bigstrongbeast/GBK-Gubkinskiy/Laser/5/mm=5_x1_10.07.26_GBK bottom 0125_FPlen=2980_FPwid=1480.dxf

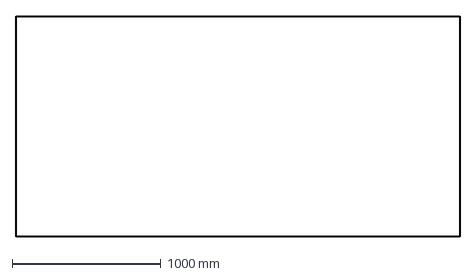
[picture p3: CAD file, 2026-08-14]
Laser/5/mm=5_x1_10.07.26_GBK bottom 0125_FPlen=2980_FPwid=1480.dxf
2980.0 x 1480.0 mm
