bigstrongbeast/GBK-Gubkinskiy/распред камера губкинск лазер/22.09.26_GBK-RK-0034 tube segmeng 4.dxf

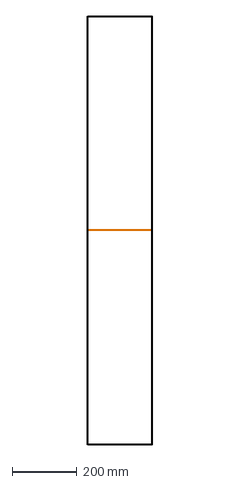
[picture p5: CAD file, 2026-09-22]
распред камера губкинск лазер/22.09.26_GBK-RK-0034 tube segmeng 4.dxf
200.0 x 1327.4 mm
