bigstrongbeast/GBK-Gubkinskiy/Laser/5/mm=5_x1_10.07.26_GBK bottom 0125_FPwid=1480_Project=.dxf

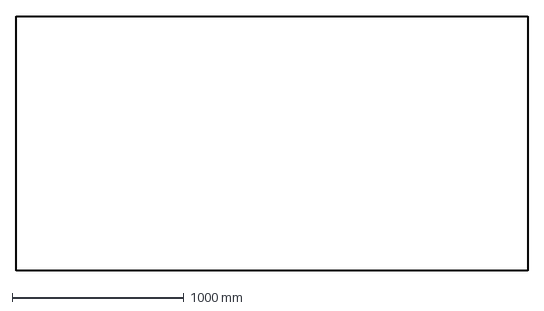
[picture p6: CAD file, 2026-08-14]
Laser/5/mm=5_x1_10.07.26_GBK bottom 0125_FPwid=1480_Project=.dxf
2980.0 x 1480.0 mm
