bigstrongbeast/GBK-Gubkinskiy/Laser/mm=2_x2_23.10.26_GBK-RK-0051 Cipolletti R.dxf

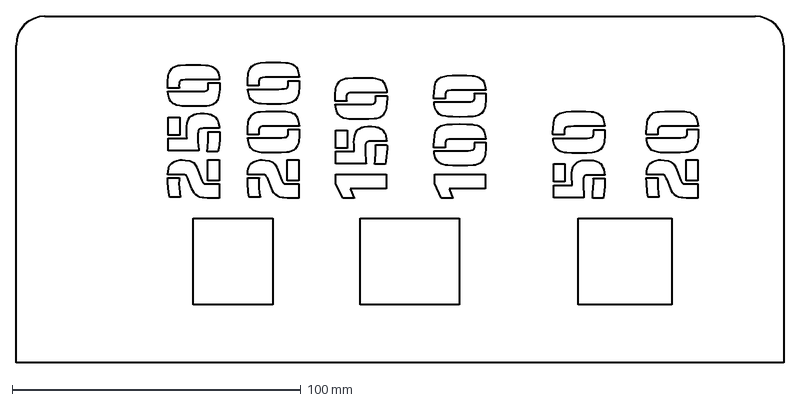
[picture p7: CAD file, 2026-10-23]
Laser/mm=2_x2_23.10.26_GBK-RK-0051 Cipolletti R.dxf
266.0 x 120.0 mm
