bigstrongbeast/GBK-Gubkinskiy/распред камера губкинск лазер/22.09.26_Деталь2.dxf

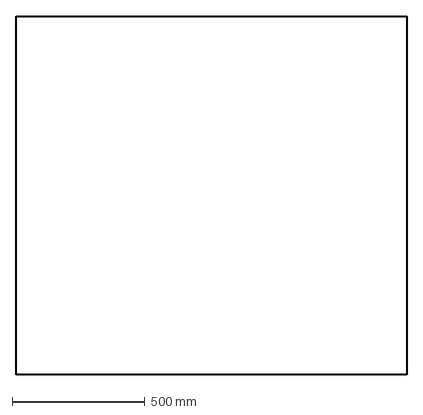
[picture p8: CAD file, 2026-09-22]
распред камера губкинск лазер/22.09.26_Деталь2.dxf
1471.0 x 1350.0 mm
