bigstrongbeast/GBK-Gubkinskiy/Распредкамера/23.10.26_2mm_x2_GBK-RK-0052 weir scale L.dxf

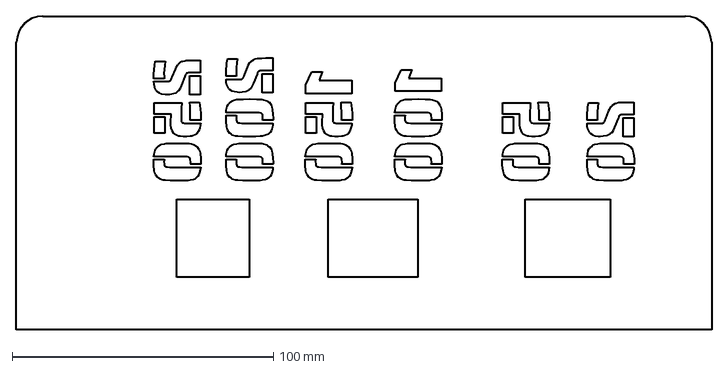
[picture p9: CAD file, 2026-10-23]
Распредкамера/23.10.26_2mm_x2_GBK-RK-0052 weir scale L.dxf
266.0 x 120.0 mm
