bigstrongbeast/GBK-Gubkinskiy/GBK 0001 Чертежи лазер 10.09.26.dxf

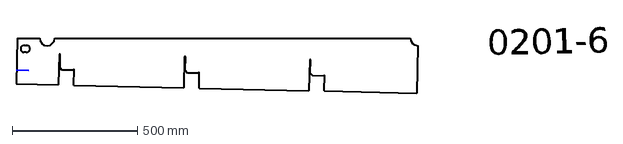
[picture p10: CAD file, 2026-09-14]
GBK 0001 Чертежи лазер 10.09.26.dxf
0201-6
