bigstrongbeast/GBK-Gubkinskiy/распред камера губкинск лазер/22.09.26_GBK-RK-0032 tube segmeng 2.dxf

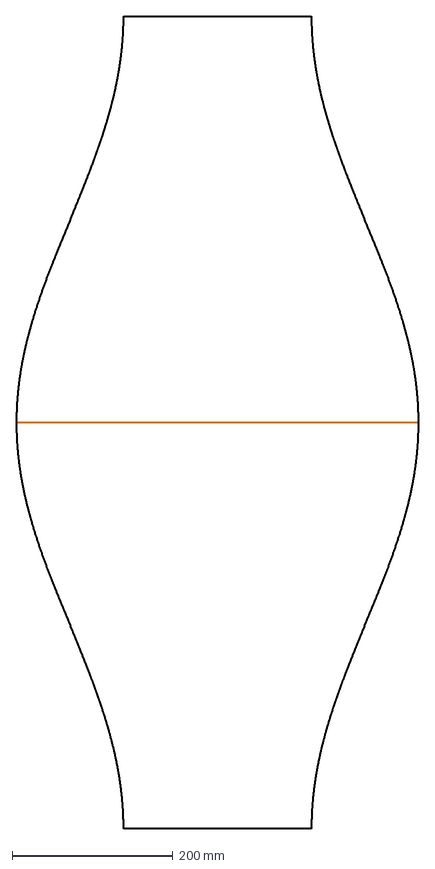
[picture p13: CAD file, 2026-09-22]
распред камера губкинск лазер/22.09.26_GBK-RK-0032 tube segmeng 2.dxf
500.0 x 1010.2 mm
