bigstrongbeast/GBK-Gubkinskiy/Распредкамера/23.10.26_2mm_x2_GBK-RK-0051 weir scale R.dxf

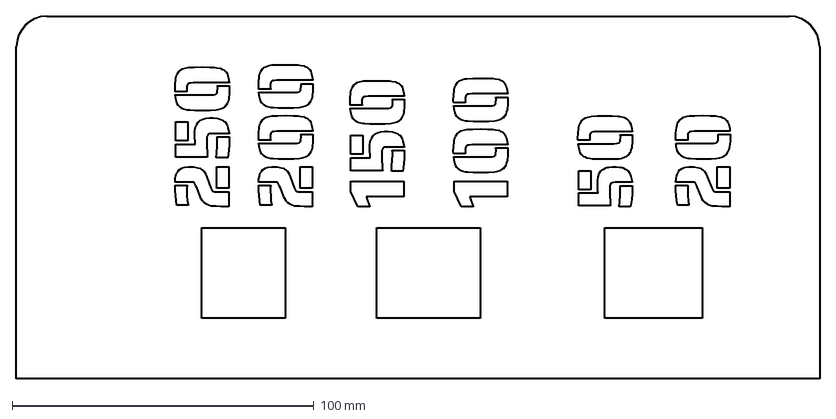
[picture p14: CAD file, 2026-10-23]
Распредкамера/23.10.26_2mm_x2_GBK-RK-0051 weir scale R.dxf
266.0 x 120.0 mm
