bigstrongbeast/GBK-Gubkinskiy/Laser/5/mm=5_x1_10.07.26_GBK bottom 0134_FPlen=1484_FPwid=64.dxf

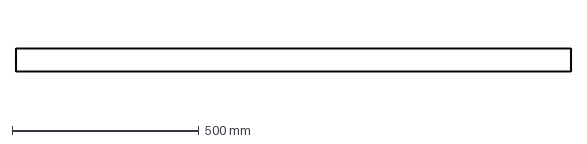
[picture p15: CAD file, 2026-08-14]
Laser/5/mm=5_x1_10.07.26_GBK bottom 0134_FPlen=1484_FPwid=64.dxf
1484.0 x 64.0 mm
