bigstrongbeast/GBK-Gubkinskiy/распред камера губкинск лазер/22.09.26_GBK-RK-0018 long wall 4.dxf

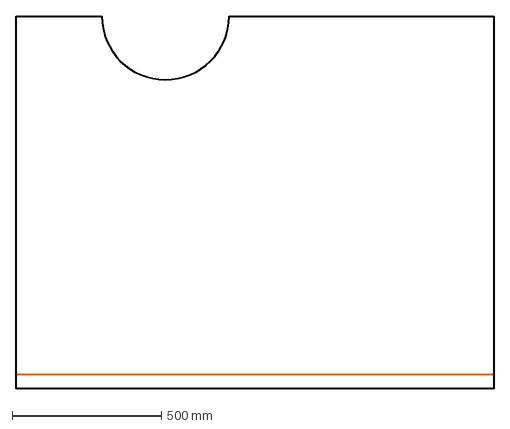
[picture p17: CAD file, 2026-09-22]
распред камера губкинск лазер/22.09.26_GBK-RK-0018 long wall 4.dxf
1600.0 x 1248.4 mm
