bigstrongbeast/GBK-Gubkinskiy/Распредкамера/GBK-RK-0831 ring plate.dxf

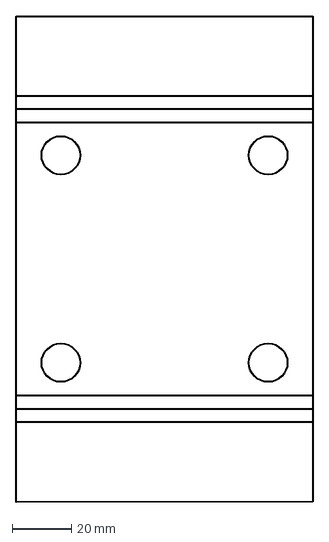
[picture p18: CAD file, 2026-10-08]
Распредкамера/GBK-RK-0831 ring plate.dxf
100.0 x 164.1 mm
