bigstrongbeast/GBK-Gubkinskiy/GBK 0001 на лазер 07.09.2026.dxf

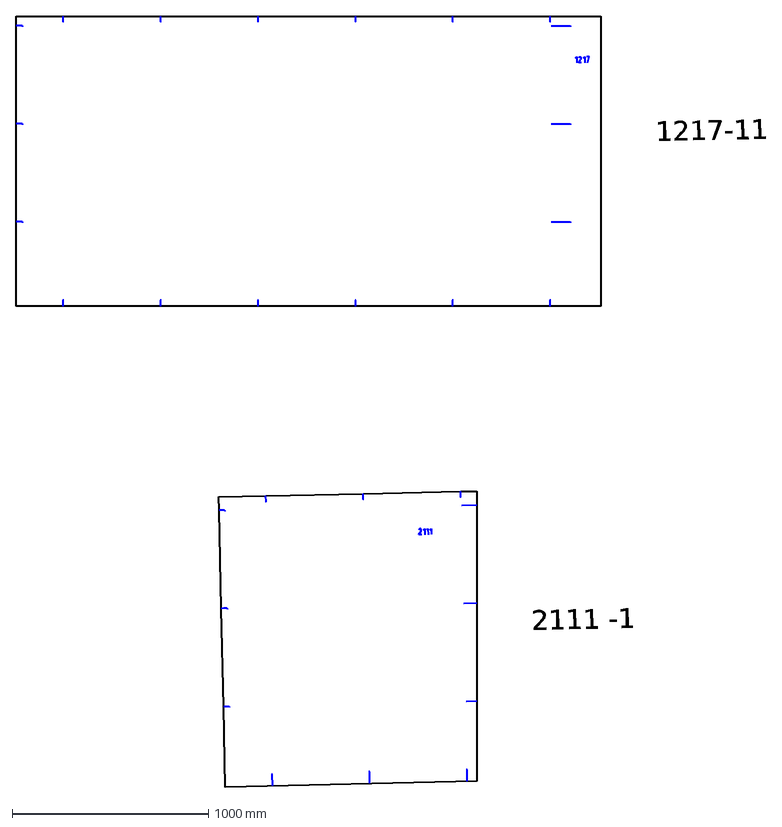
[picture p19: CAD file, 2026-09-14]
GBK 0001 на лазер 07.09.2026.dxf
1217-11
2111 -1
