bigstrongbeast/GBK-Gubkinskiy/Laser/5/mm=5_x1_10.07.26_GBK bottom 0135_FPwid=64_Project=.dxf

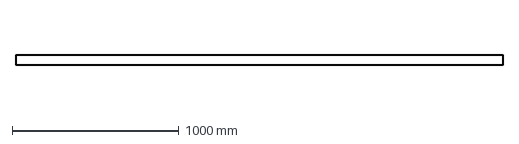
[picture p20: CAD file, 2026-08-14]
Laser/5/mm=5_x1_10.07.26_GBK bottom 0135_FPwid=64_Project=.dxf
2920.0 x 64.0 mm
