bigstrongbeast/GBK-Gubkinskiy/Распредкамера/05.10.26_3mm_8pc_GBK-RK-0832 ring plate.dxf

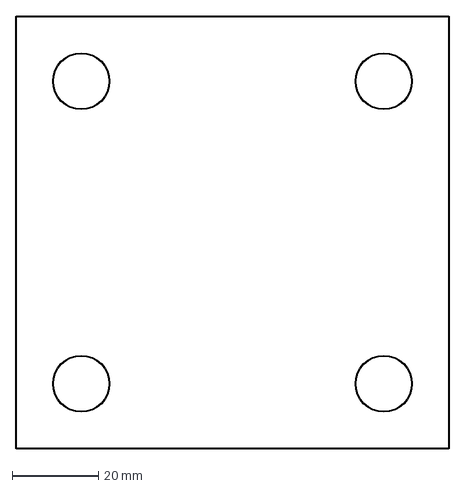
[picture p23: CAD file, 2026-10-08]
Распредкамера/05.10.26_3mm_8pc_GBK-RK-0832 ring plate.dxf
100.0 x 100.0 mm
