bigstrongbeast/GBK-Gubkinskiy/Laser/mm=2_x12_22.09.26_GBK-RK-0043 rib 3.dxf

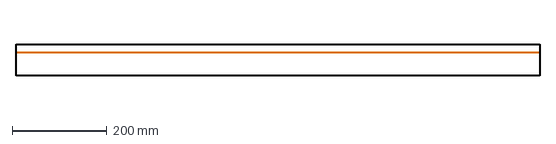
[picture p25: CAD file, 2026-09-23]
Laser/mm=2_x12_22.09.26_GBK-RK-0043 rib 3.dxf
1104.0 x 66.5 mm
