bigstrongbeast/GBK-Gubkinskiy/распред камера губкинск лазер/22.09.26_GBK-RK-0014 short wall 4.dxf

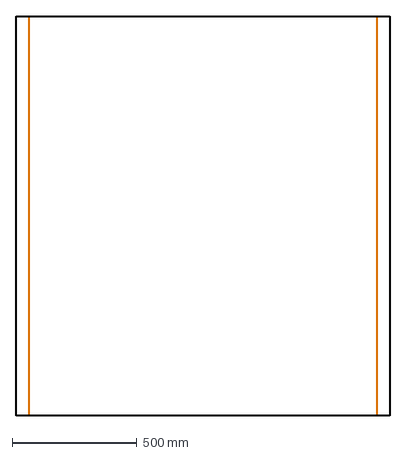
[picture p26: CAD file, 2026-09-22]
распред камера губкинск лазер/22.09.26_GBK-RK-0014 short wall 4.dxf
1496.8 x 1600.0 mm
