bigstrongbeast/GBK-Gubkinskiy/Распредкамера/GBK-RK-0832 ring plate.dxf

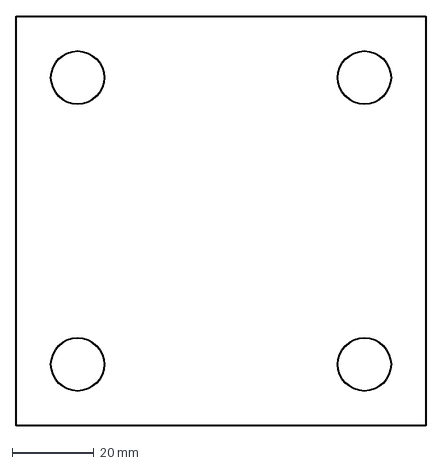
[picture p27: CAD file, 2026-10-08]
Распредкамера/GBK-RK-0832 ring plate.dxf
100.0 x 100.0 mm
