bigstrongbeast/GBK-Gubkinskiy/Laser/5/mm=5_x3_10.07.26_GBK bottom 0233.dxf

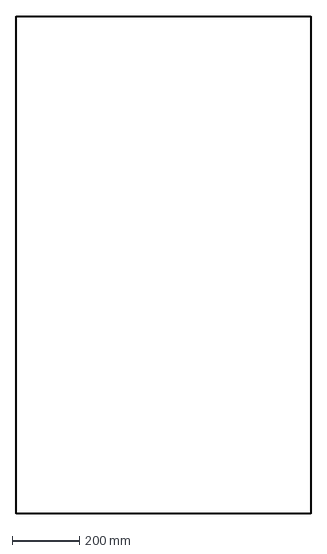
[picture p28: CAD file, 2026-07-15]
Laser/5/mm=5_x3_10.07.26_GBK bottom 0233.dxf
876.0 x 1480.0 mm
