bigstrongbeast/GBK-Gubkinskiy/Laser/mm=4_x1_22.09.26_GBK-RK-0021 bottom.dxf

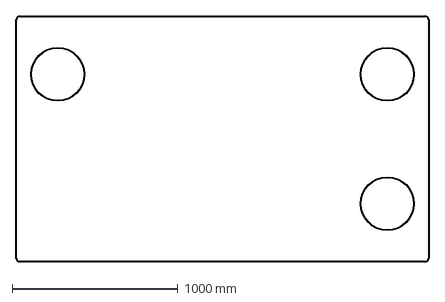
[picture p29: CAD file, 2026-09-23]
Laser/mm=4_x1_22.09.26_GBK-RK-0021 bottom.dxf
2488.0 x 1480.0 mm
