bigstrongbeast/GBK-Gubkinskiy/распред камера губкинск лазер/22.09.26_GBK-RK-0015 partition 5.dxf

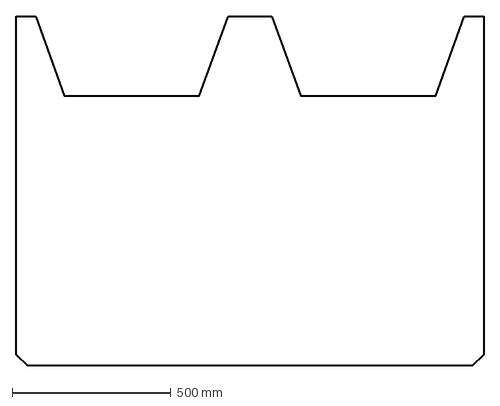
[picture p30: CAD file, 2026-09-22]
распред камера губкинск лазер/22.09.26_GBK-RK-0015 partition 5.dxf
1470.0 x 1100.0 mm
