bigstrongbeast/GBK-Gubkinskiy/Распредкамера/05.10.26_3mm_8pc_GBK-RK-0831 ring plate.dxf

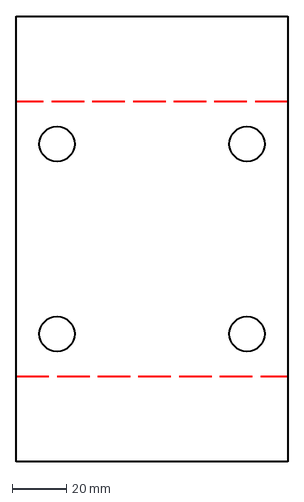
[picture p31: CAD file, 2026-10-08]
Распредкамера/05.10.26_3mm_8pc_GBK-RK-0831 ring plate.dxf
100.0 x 164.1 mm
