bigstrongbeast/GBK-Gubkinskiy/Laser/5/mm=5_x14_10.07.26_0923_CPY.dxf

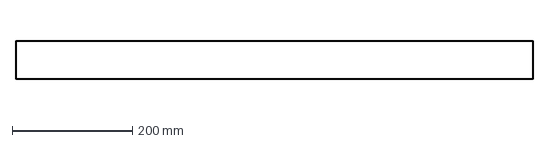
[picture p32: CAD file, 2026-07-15]
Laser/5/mm=5_x14_10.07.26_0923_CPY.dxf
858.0 x 64.0 mm
