bigstrongbeast/GBK-Gubkinskiy/Laser/mm=3_x4_22.09.26_GBK-RK-0018 angle 1.dxf

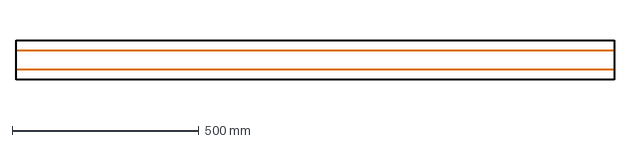
[picture p33: CAD file, 2026-09-23]
Laser/mm=3_x4_22.09.26_GBK-RK-0018 angle 1.dxf
1600.0 x 106.8 mm
