bigstrongbeast/GBK-Gubkinskiy/распред камера губкинск лазер/22.09.26_GBK-RK-0043 rib 3.dxf

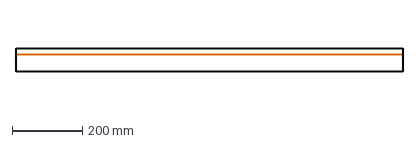
[picture p34: CAD file, 2026-09-22]
распред камера губкинск лазер/22.09.26_GBK-RK-0043 rib 3.dxf
1104.0 x 66.5 mm
