bigstrongbeast/GBK-Gubkinskiy/Laser/5/mm=5_x3_10.07.26_GBK bottom 0231.dxf

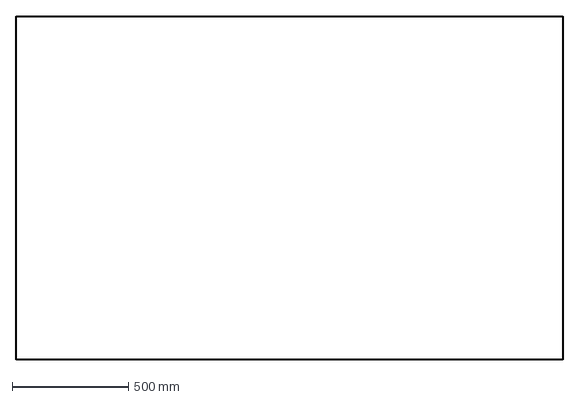
[picture p35: CAD file, 2026-07-15]
Laser/5/mm=5_x3_10.07.26_GBK bottom 0231.dxf
2350.0 x 1480.0 mm
