bigstrongbeast/GBK-Gubkinskiy/Laser/mm=3_x1_22.09.26_GBK-RK-0034 tube segmeng 4.dxf

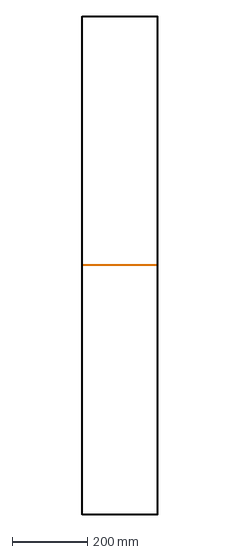
[picture p36: CAD file, 2026-09-23]
Laser/mm=3_x1_22.09.26_GBK-RK-0034 tube segmeng 4.dxf
200.0 x 1327.4 mm
