bigstrongbeast/GBK-Gubkinskiy/распред камера губкинск лазер/22.09.26_GBK-RK-0041 rib 1.dxf

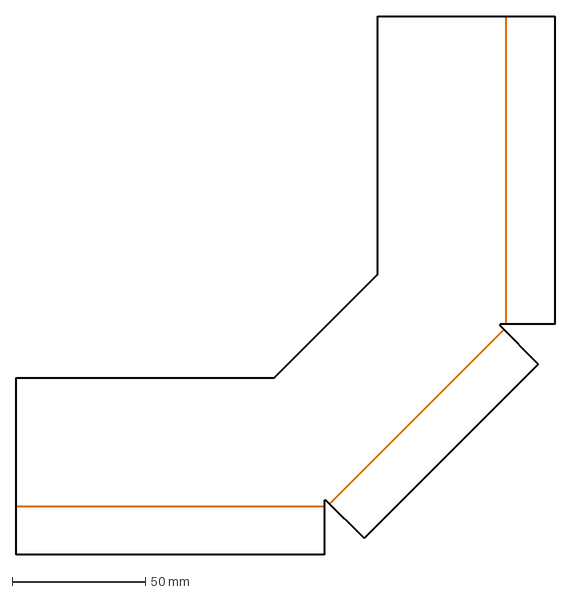
[picture p37: CAD file, 2026-09-22]
распред камера губкинск лазер/22.09.26_GBK-RK-0041 rib 1.dxf
202.4 x 202.4 mm
