bigstrongbeast/GBK-Gubkinskiy/Laser/5/mm=5_x3_10.07.26_0932_CPY1_CPY.dxf

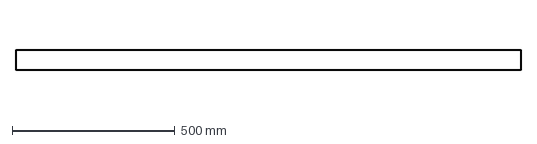
[picture p38: CAD file, 2026-07-15]
Laser/5/mm=5_x3_10.07.26_0932_CPY1_CPY.dxf
1553.0 x 64.0 mm
