bigstrongbeast/GBK-Gubkinskiy/Laser/mm=3_x1_22.09.26_Деталь1.dxf

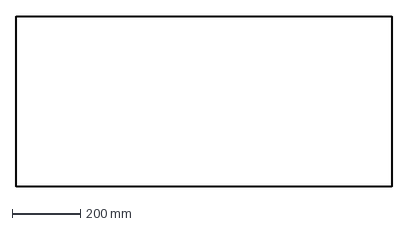
[picture p39: CAD file, 2026-09-23]
Laser/mm=3_x1_22.09.26_Деталь1.dxf
1100.0 x 500.0 mm
