bigstrongbeast/GBK-Gubkinskiy/распред камера губкинск лазер/22.09.26_Деталь1.dxf

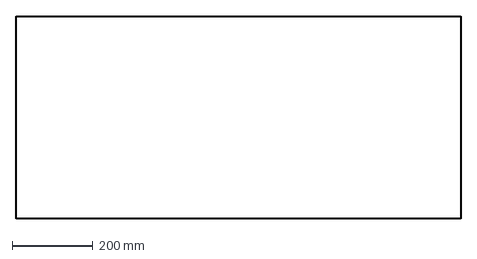
[picture p40: CAD file, 2026-09-22]
распред камера губкинск лазер/22.09.26_Деталь1.dxf
1100.0 x 500.0 mm
