bigstrongbeast/GBK-Gubkinskiy/Laser/5/mm=5_x2_10.07.26_0921_CPY1.dxf

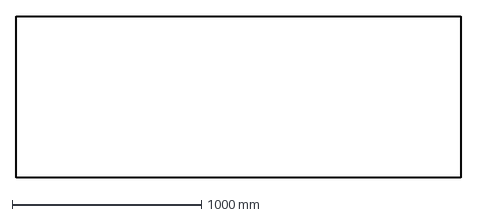
[picture p41: CAD file, 2026-07-15]
Laser/5/mm=5_x2_10.07.26_0921_CPY1.dxf
2350.0 x 854.0 mm
