bigstrongbeast/GBK-Gubkinskiy/распред камера губкинск лазер/22.09.26_GBK-RK-0017 long wall 3.dxf

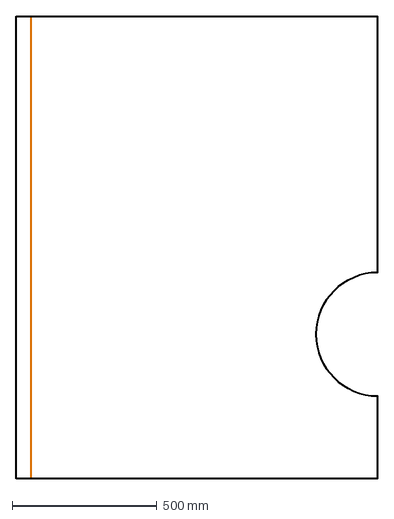
[picture p43: CAD file, 2026-09-22]
распред камера губкинск лазер/22.09.26_GBK-RK-0017 long wall 3.dxf
1248.4 x 1600.0 mm
