bigstrongbeast/GBK-Gubkinskiy/Laser/5/mm=5_x49_10.07.26_0923_CPY1.dxf

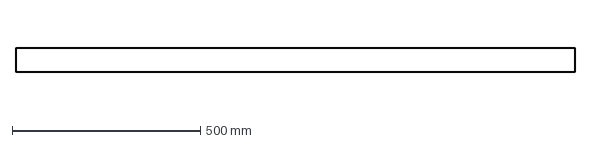
[picture p44: CAD file, 2026-07-15]
Laser/5/mm=5_x49_10.07.26_0923_CPY1.dxf
1484.0 x 64.0 mm
