bigstrongbeast/GBK-Gubkinskiy/Laser/mm=2_x1_22.09.26_GBK-RK-0016 partition 6.dxf

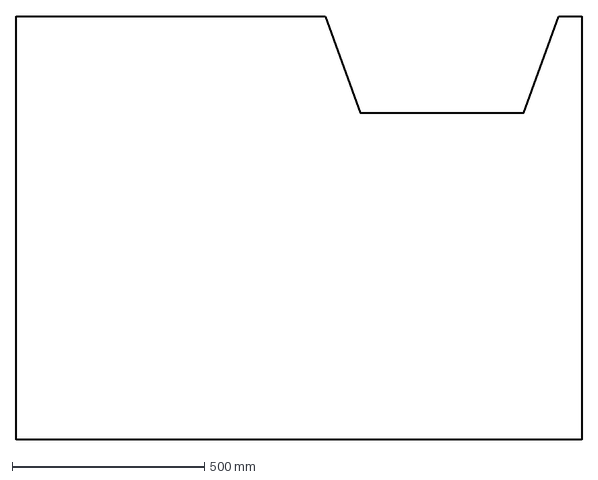
[picture p45: CAD file, 2026-09-23]
Laser/mm=2_x1_22.09.26_GBK-RK-0016 partition 6.dxf
1470.0 x 1100.0 mm
