bigstrongbeast/GBK-Gubkinskiy/распред камера губкинск лазер/22.09.26_GBK-RK-0042 rib 2.dxf

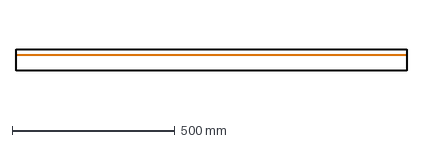
[picture p46: CAD file, 2026-09-22]
распред камера губкинск лазер/22.09.26_GBK-RK-0042 rib 2.dxf
1200.0 x 66.5 mm
