bigstrongbeast/GBK-Gubkinskiy/Laser/5/mm=5_x35_10.07.26_0921_CPY.dxf

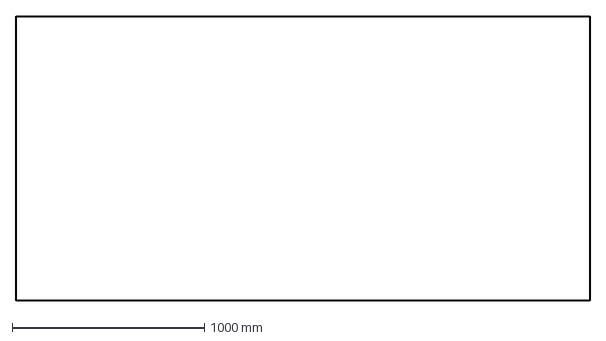
[picture p47: CAD file, 2026-07-15]
Laser/5/mm=5_x35_10.07.26_0921_CPY.dxf
2980.0 x 1480.0 mm
