bigstrongbeast/GBK-Gubkinskiy/распред камера губкинск лазер/22.09.26_GBK-RK-0021 bottom.dxf

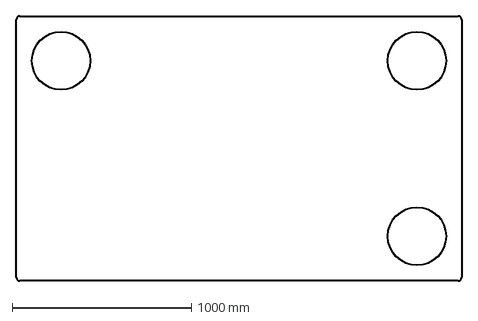
[picture p49: CAD file, 2026-09-22]
распред камера губкинск лазер/22.09.26_GBK-RK-0021 bottom.dxf
2488.0 x 1480.0 mm
