bigstrongbeast/GBK-Gubkinskiy/Laser/5/mm=5_x8_10.07.26_0931_CPY.dxf

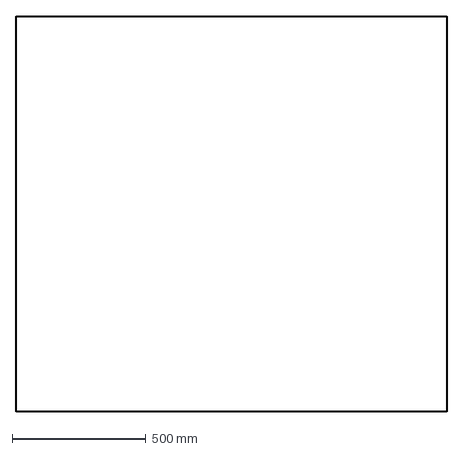
[picture p50: CAD file, 2026-07-15]
Laser/5/mm=5_x8_10.07.26_0931_CPY.dxf
1613.0 x 1480.0 mm
