bigstrongbeast/GBK-Gubkinskiy/Laser/mm=4_x1_22.09.26_GBK-RK-0820 ring plate.dxf

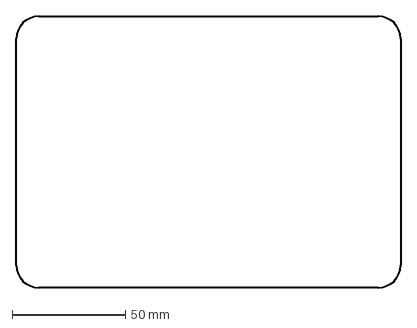
[picture p51: CAD file, 2026-09-23]
Laser/mm=4_x1_22.09.26_GBK-RK-0820 ring plate.dxf
170.0 x 120.0 mm
