bigstrongbeast/GBK-Gubkinskiy/распред камера губкинск лазер/22.09.26_GBK-RK-0031 tube segmeng 1.dxf

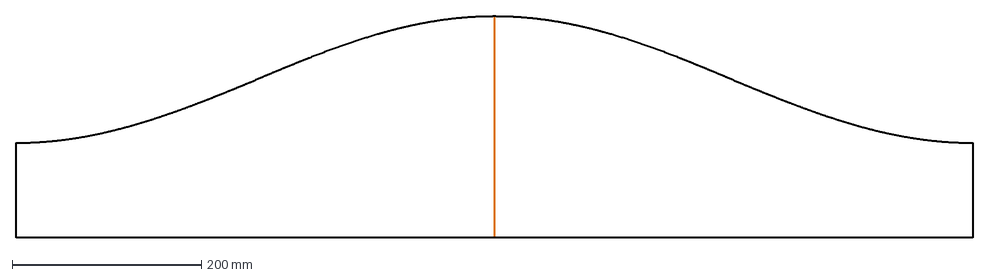
[picture p52: CAD file, 2026-09-22]
распред камера губкинск лазер/22.09.26_GBK-RK-0031 tube segmeng 1.dxf
1010.2 x 233.4 mm
