bigstrongbeast/GBK-Gubkinskiy/Laser/5/mm=5_x10_10.07.26_0921_CPY1_CPY.dxf

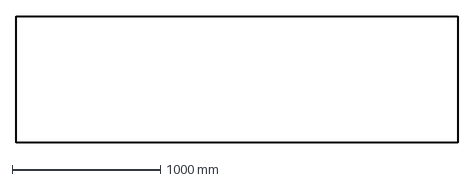
[picture p53: CAD file, 2026-07-15]
Laser/5/mm=5_x10_10.07.26_0921_CPY1_CPY.dxf
2980.0 x 854.0 mm
