bigstrongbeast/GBK-Gubkinskiy/Laser/mm=2_x12_22.09.26_GBK-RK-0041 rib 1.dxf

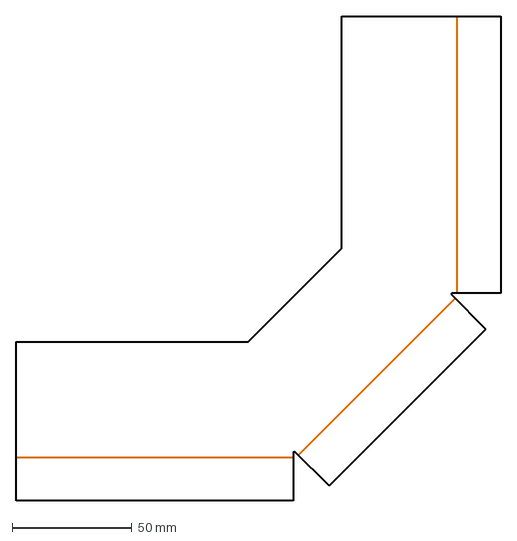
[picture p54: CAD file, 2026-09-23]
Laser/mm=2_x12_22.09.26_GBK-RK-0041 rib 1.dxf
202.4 x 202.4 mm
