bigstrongbeast/GBK-Gubkinskiy/распред камера губкинск лазер/22.09.26_GBK-RK-0013 long wall 3.dxf

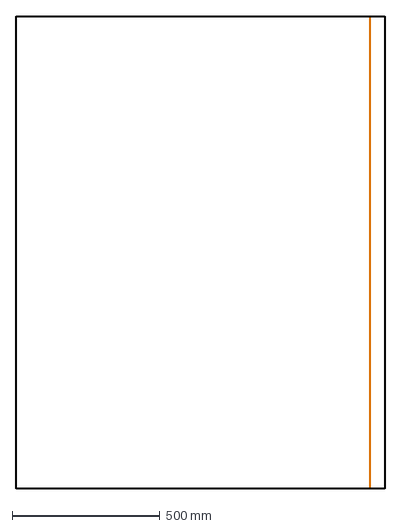
[picture p55: CAD file, 2026-09-22]
распред камера губкинск лазер/22.09.26_GBK-RK-0013 long wall 3.dxf
1248.4 x 1600.0 mm
