bigstrongbeast/GBK-Gubkinskiy/Laser/5/mm=5_x45_10.07.26_0922_CPY1.dxf

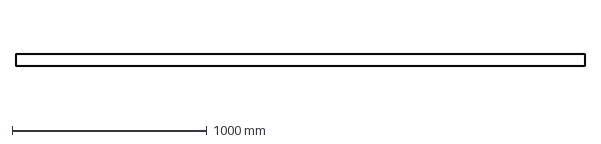
[picture p56: CAD file, 2026-07-15]
Laser/5/mm=5_x45_10.07.26_0922_CPY1.dxf
2920.0 x 64.0 mm
