bigstrongbeast/GBK-Gubkinskiy/Laser/mm=2_x2_22.09.26_Деталь2.dxf

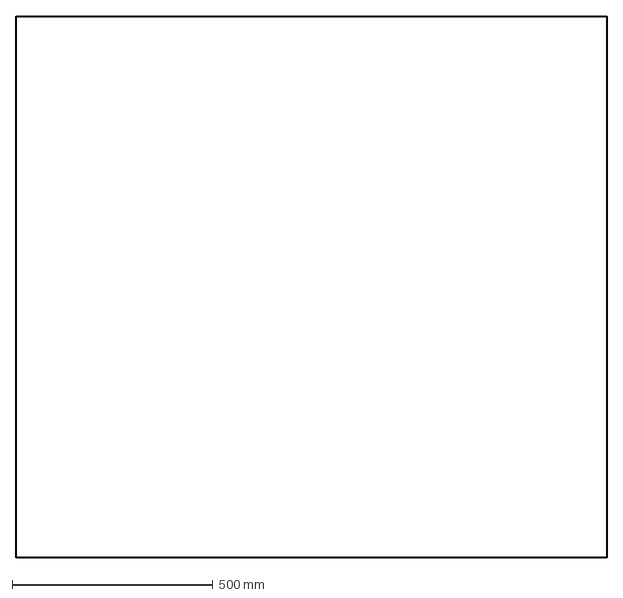
[picture p57: CAD file, 2026-09-23]
Laser/mm=2_x2_22.09.26_Деталь2.dxf
1471.0 x 1350.0 mm
