bigstrongbeast/GBK-Gubkinskiy/распред камера губкинск лазер/22.09.26_GBK-RK-0016 partition 6.dxf

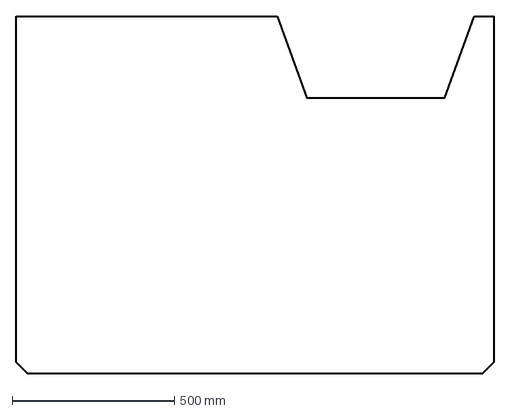
[picture p58: CAD file, 2026-09-22]
распред камера губкинск лазер/22.09.26_GBK-RK-0016 partition 6.dxf
1470.0 x 1100.0 mm
