bigstrongbeast/GBK-Gubkinskiy/Laser/5/mm=5_x2_10.07.26_0931_CPY1.dxf

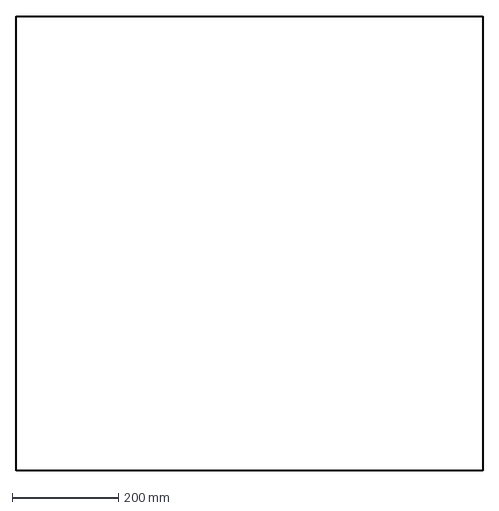
[picture p59: CAD file, 2026-07-15]
Laser/5/mm=5_x2_10.07.26_0931_CPY1.dxf
876.0 x 854.0 mm
