bigstrongbeast/GBK-Gubkinskiy/Laser/mm=4_x2_22.09.26_ухо.dxf

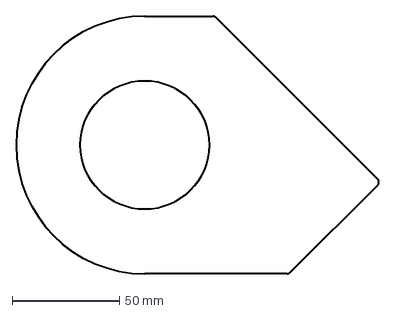
[picture p60: CAD file, 2026-09-23]
Laser/mm=4_x2_22.09.26_ухо.dxf
169.2 x 120.0 mm
