bigstrongbeast/GBK-Gubkinskiy/Laser/mm=3_x1_22.09.26_GBK-RK-0017 long wall 3.dxf

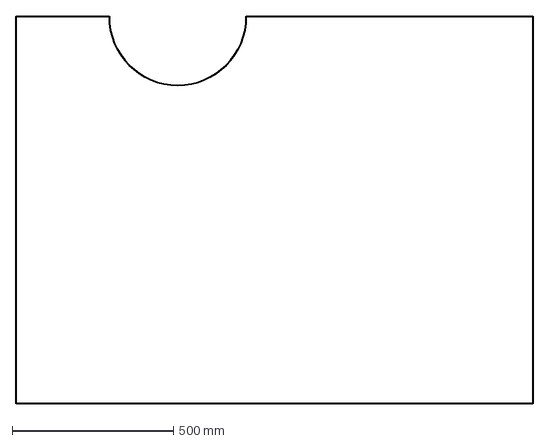
[picture p61: CAD file, 2026-09-23]
Laser/mm=3_x1_22.09.26_GBK-RK-0017 long wall 3.dxf
1600.0 x 1200.0 mm
