bigstrongbeast/GBK-Gubkinskiy/Laser/mm=2_x1_22.09.26_GBK-RK-0015 partition 5.dxf

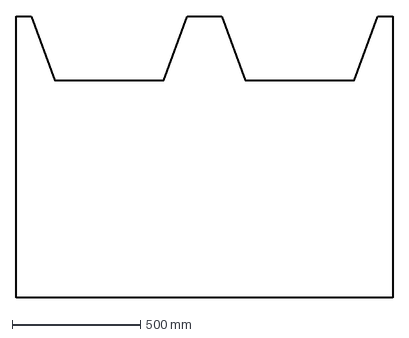
[picture p62: CAD file, 2026-09-23]
Laser/mm=2_x1_22.09.26_GBK-RK-0015 partition 5.dxf
1470.0 x 1100.0 mm
