bigstrongbeast/GBK-Gubkinskiy/Laser/mm=3_x2_22.09.26_GBK-RK-0014 short wall 4.dxf

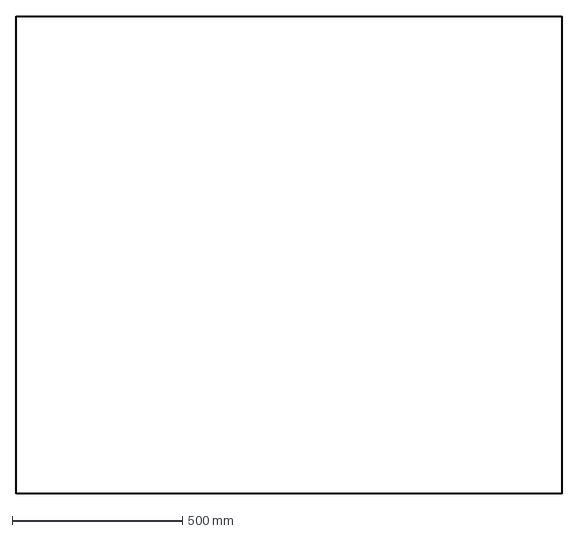
[picture p63: CAD file, 2026-09-23]
Laser/mm=3_x2_22.09.26_GBK-RK-0014 short wall 4.dxf
1600.0 x 1400.0 mm
