bigstrongbeast/GBK-Gubkinskiy/Laser/mm=2_x6_22.09.26_GBK-RK-0042 rib 2.dxf

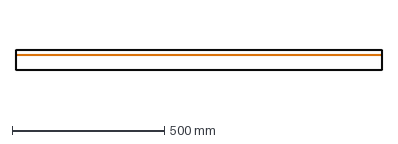
[picture p64: CAD file, 2026-09-23]
Laser/mm=2_x6_22.09.26_GBK-RK-0042 rib 2.dxf
1200.0 x 66.5 mm
