bigstrongbeast/GBK-Gubkinskiy/(list of files, cad)

Other CAD files:
GBK-RK-0001 сборка первое.dwg
Refs/Техсхема Губкинский без резервуара осадка.dwg
Распредкамера/водослив.dwg
GBK-RK-0001.dwg
Refs/емкости в галерее.dwg
Refs/Gubkinskiy_02_27_ rvt (2026 RVT) - Разрез - Section 2.dwg
GBK 0001 на лазер 07.09.26 11_GBK 001 Ребра усилители_3.dwg
GBK 0001 на лазер 07.09.26.dwg
GBK 0001 Чертежи лазер 20.08.26.dxf
GBK 0001 Чертежи гибки.dwg
емкости в галерее 10.07.26.dwg
000 ASY GBK Gubkinskiy CUT LASER.iam
000 ASY GBK Gubkinskiy.iam
01 ASY GBK wall shield 1.1.1.iam
01.3 GBK stringer 1.ipt
010 ASY GBK T beams 1.iam
010 ASY GBK T beams 1/Frame/Frame 1786954762414.iam
010 ASY GBK T beams 1/Frame/ISO 4019 100x100x4 1786954763984.ipt
010 ASY GBK T beams 1/Frame/ISO 4019 100x100x4 1786954764016.ipt
010 ASY GBK T beams 1/Frame/ISO 4019 100x100x4 1786954764050.ipt
010 ASY GBK T beams 1/Frame/ISO 4019 100x100x4 1786954764080.ipt
010 ASY GBK T beams 1/Frame/Skeleton 1786954762415.ipt
010 ASY GBK Tube frame 1.iam
010.7 GBK shield.ipt
01001 ASY GBK wall shield Center 10.iam
01011 GBK Center rib 3.ipt
01013 GBK stringer C7.ipt
01014 GBK stringer C8.ipt
0138 GBK shield 8.ipt
02 ASY GBK wall shield 1.1.2.iam
02.1 GBK main rib.ipt
02.2 GBK rib.ipt
0233 GBK stringer 3.ipt
0241 GBK shield 4.ipt
0241 GBK stringer 4.ipt
0242 GBK stringer 5.ipt
0243 GBK stringer 6.ipt
03.1 GBK main3 rib.ipt
0371 GBK stringer 7.ipt
0372 GBK stringer 8.ipt
0381 GBK stringer 7.ipt
0382 GBK stringer 8.ipt
04.2 GBK rib.ipt
0411 GBK Center main rib.ipt
0413 GBK stringer C1.ipt
0414 GBK stringer C2.ipt
0415 GBK stringer C3.ipt
05.7 GBK shield.ipt
07 ASY GBK wall shield 1.3.1.iam
07.2 GBK rib.ipt
0701 ASY GBK wall shield Center 4.iam
0711 GBK Center rib 2.ipt
0713 GBK stringer C1.ipt
0714 GBK stringer C2.ipt
0715 GBK stringer C3.ipt
08 ASY GBK wall shield 1.3.8.iam
08.2 GBK rib.ipt
090 ASY bottom.iam
1019 GBK shield.ipt
ASY GBK 1110 long wall shield 1.iam
ASY GBK 1120 long wall shield 2.iam
ASY GBK 1210 long wall shield 3.iam
ASY GBK 1310 long wall shield 4.iam
ASY GBK 1320 long wall shield 5.iam
ASY GBK 2110 short wall shield 1.iam
ASY GBK 2120 short wall shield 2.iam
ASY GBK 2130 short wall shield 3.iam
ASY GBK 2210 short wall shield 4.iam
ASY GBK 2220 short wall shield 5.iam
ASY GBK 2230 short wall shield 6.iam
ASY GBK 2310 short wall shield 7.iam
ASY GBK 2320 short wall shield 8.iam
ASY GBK 2330 short wall shield 9.iam
ASY GBK 3110 central wall shield 1.iam
ASY GBK 3120 central wall shield 2.iam
ASY GBK 3130 central wall shield 3.iam
ASY GBK 3210 central wall shield 4.iam
ASY GBK 3210 wall shield Center 3.iam
ASY GBK 3220 central wall shield 5.iam
ASY GBK 3230 central wall shield 6.iam
ASY GBK 3310 central wall shield 7.iam
ASY GBK 3320 central wall shield 8.iam
ASY GBK 3330 central wall shield 9.iam
ASY GBK bottom 0010.iam
ASY GBK bottom 0020.iam
ASY GBK bottom 0021.iam
ASY GBK bottom 0021_CPY.iam
ASY GBK bottom 0022.iam
ASY GBK bottom 0023.iam
ASY GBK bottom 0024.iam
ASY GBK длинная стенка.iam
ASY GBK короткая стенка.iam
ASY GBK правая стенка.iam
ASY GBK предварительная торцевая.iam
ASY GBK центральная стенка.iam
Assembly3.iam
Assembly4.iam
DIN 2605 Колено 90 градусов, тип 2 323.9 - 2.9S.ipt
GBK 0000 Чертежи.idw
GBK 0001 Чертежи гибки.idw
GBK 0001 Чертежи лазер 10.09.26.dwg
GBK 0001 Чертежи лазер 20.08.26.dwg
GBK 0001 на лазер 07.09.2026.dwg
GBK 0101 main rib.ipt
GBK 0102 stringer 1.ipt
GBK 0103 stringer 2.ipt
GBK 0104 stringer 3.ipt
GBK 0201 second rib.ipt
GBK 0202 stringer 4.ipt
GBK 0203 stringer 5.ipt
GBK 0204 stringer 6.ipt
GBK 0301 third rib.ipt
GBK 0302 stringer 7.ipt
GBK 0303 stringer 8.ipt
GBK 1018 shield 2.ipt
GBK 1111 main rib.ipt
GBK 1112 stringer 1.ipt
GBK 1113 stringer 2.ipt
GBK 1114 stringer 3.ipt
GBK 1115 shield 1.ipt
GBK 1126 shield 1.2.ipt
GBK 1211 second rib.ipt
GBK 1217 shield 2.ipt
GBK 1318 shield.ipt
GBK 1321 rib.ipt
GBK 1322 stringer 7.ipt
GBK 1323 stringer 8.ipt
GBK 1325 shield 1.2.ipt
GBK 2111 shield 1.ipt
GBK 2122 shield 2.ipt
GBK 2131 shield 3.ipt
GBK 2133 shield 3.ipt
GBK 2211 shield 1.ipt
GBK 2211 shield 2.ipt
GBK 2211 shield 4.ipt
GBK 2221 shield 5.ipt
GBK 2236 shield 6.ipt
GBK 2311 shield 7.ipt
GBK 2321 shield 8.ipt
GBK 2339 shield 9.ipt
GBK 3101 Center main rib.ipt
GBK 3102 stringer 1.ipt
GBK 3103 stringer 2.ipt
GBK 3104 stringer 3.ipt
GBK 3111 shield 1.ipt
GBK 3112 central main rib.ipt
GBK 3112 central main rib_CPY.ipt
GBK 3112 central main rib_CPY1.ipt
GBK 3113 stringer 1.ipt
GBK 3114 stringer 2.ipt
GBK 3115 stringer 3.ipt
GBK 3122 shield 2.ipt
GBK 3133 shield 3.ipt
GBK 3201 Center second rib.ipt
GBK 3202 stringer 4.ipt
GBK 3203 stringer 5.ipt
GBK 3204 stringer 6.ipt
GBK 3212 central second rib.ipt
GBK 3212 central second rib_CPY.ipt
GBK 3212 central second rib_CPY1.ipt
GBK 3214 shield 4.ipt
GBK 3215 stringer 5.ipt
GBK 3216 stringer 6.ipt
GBK 3217 stringer 4.ipt
GBK 3225 shield 5.ipt
GBK 3236 shield 6.ipt
GBK 3301 Center third rib.ipt
GBK 3302 stringer 7.ipt
GBK 3303 stringer 8.ipt
GBK 3311 central third rib_CPY1.ipt
GBK 3312 stringer 7.ipt
GBK 3313 stringer 8.ipt
GBK 3314 central third rib.ipt
GBK 3315 central third rib.ipt
GBK 3317 shield 7.ipt
GBK 3328 shield 8.ipt
GBK 3339 shield 9.ipt
GBK Gubkinskiy Distribution chamber frame dummy.ipt
GBK bottom.ipt
GBK dummy wall 1.ipt
GBK dummy wall 4.ipt
GBK overall model.ipt
GBK-RK-0110 distrib chamber.iam
GBK-RK-0833 эскиз.ipt
GBK-RK-0833.iam
GBK-RK-0833/Frame/Frame 1790944619299.iam
GBK-RK-0833/Frame/Frame 1790944619299_MIR.iam
GBK-RK-0833/Frame/Frame 1790944619299_MIR1.iam
GBK-RK-0833/Frame/Frame 1790944619299_MIR_MIR.iam
GBK-RK-0833/Frame/Skeleton 1790944619300.ipt
GBK-RK-0833/Frame/Skeleton 1790944619300_MIR.ipt
GBK-RK-0833/Frame/Skeleton 1790944619300_MIR1.ipt
GBK-RK-0833/Frame/Skeleton 1790944619300_MIR_MIR.ipt
GBK-RK-0833/Frame/ГОСТ 30245-2003 Труба 60x40x3 ГОСТ 30245-2003 1790944620768.ipt
GBK-RK-0833_MIR.iam
GBK-RK-0833_MIR1.iam
GBK-RK-0833_MIR_MIR.iam
cc/en-US/JIS B 2302 CN/JIS B 2302 Close Nipple 2.ipt
dummy/ASY DUMMY TANK.iam
dummy/ASY GBK 1110 long wall shield 1_Dummy.iam
dummy/GBK 0101 main rib_Dummy.ipt
dummy/GBK 0103 stringer 2_Dummy.ipt
dummy/GBK 0104 stringer 3_Dummy.ipt
dummy/GBK 1111 shield 1_Dummy.ipt
dummy/OldVersions/ASY GBK 1110 long wall shield 1_Dummy.0003.iam
dummy/OldVersions/GBK 0101 main rib_Dummy.0002.ipt
dummy/OldVersions/GBK 0103 stringer 2_Dummy.0003.ipt
dummy/OldVersions/GBK 0104 stringer 3_Dummy.0003.ipt
dummy/OldVersions/GBK 1111 shield 1_Dummy.0002.ipt
dummy/Pocket.ipt
pallet jack dummy.ipt
Обвязка профилем/GBK 4001 frame 1 sketch.ipt
Пол/092.iam
Пол/0921.ipt
Пол/0921_CPY_CPY.ipt
Пол/0922.ipt
Пол/0922_CPY.ipt
Пол/0922_CPY_CPY.ipt
Пол/0923.ipt
Пол/0923_CPY_CPY.ipt
Пол/092_CPY_CPY.iam
Пол/093.iam
Пол/0931.ipt
Пол/0932.ipt
Пол/0932_CPY.ipt
Пол/0933.ipt
Пол/0933_CPY.ipt
Пол/0933_CPY1.ipt
Пол/GBK bottom 0111.ipt
Пол/GBK bottom 0112.ipt
Пол/GBK bottom 0113.ipt
Пол/GBK bottom 0113_CPY.ipt
Пол/GBK bottom 0124.ipt
Пол/GBK bottom 0125.ipt
Пол/GBK bottom 0127.ipt
Пол/GBK bottom 0128.ipt
Пол/GBK bottom 0128_CPY.ipt
Пол/GBK bottom 0131.ipt
Пол/GBK bottom 0132.ipt
Пол/GBK bottom 0132_CPY.ipt
Пол/GBK bottom 0133.ipt
Пол/GBK bottom 0134.ipt
Пол/GBK bottom 0135.ipt
Пол/GBK bottom 0231.ipt
Распредкамера/GBK ASY Gubkinskiy Distribution chamber frame dummy.iam
Распредкамера/GBK ASY Gubkinskiy Distribution chamber frame dummy/Frame/Frame 1789117000139.iam
Распредкамера/GBK ASY Gubkinskiy Distribution chamber frame dummy/Frame/ISO 657_15 SB 140x15 1789117038127.ipt
Распредкамера/GBK ASY Gubkinskiy Distribution chamber frame dummy/Frame/ISO 657_15 SB 200x27 1789117001820.ipt
Распредкамера/GBK ASY Gubkinskiy Distribution chamber frame dummy/Frame/ISO 657_15 SB 200x27 1789117015865.ipt
Распредкамера/GBK ASY Gubkinskiy Distribution chamber frame dummy/Frame/ISO 657_15 SB 200x27 1789117015887.ipt
Распредкамера/GBK ASY Gubkinskiy Distribution chamber frame dummy/Frame/Skeleton 1789117000140.ipt
Распредкамера/GBK-RK-0001.iam
Распредкамера/GBK-RK-0001.idw
Распредкамера/GBK-RK-0002 RK dummy.ipt
Распредкамера/GBK-RK-0003 RK dummy 3.ipt
Распредкамера/GBK-RK-0004 RK dummy 4.ipt
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
