bigstrongbeast/GBK-Gubkinskiy/GBK 0000 Чертежи черновик 09.07.26.pdf

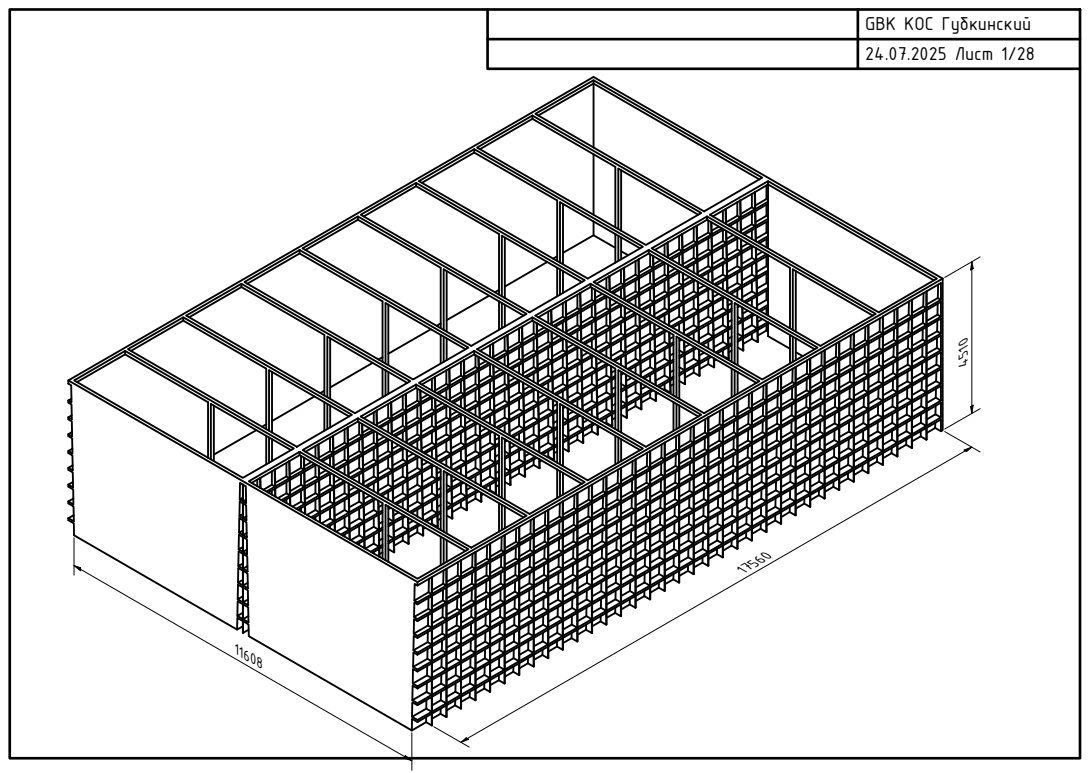
[picture p65: page 1]

GBK КОС Губкинский
24.07.2025 Лист 1/28

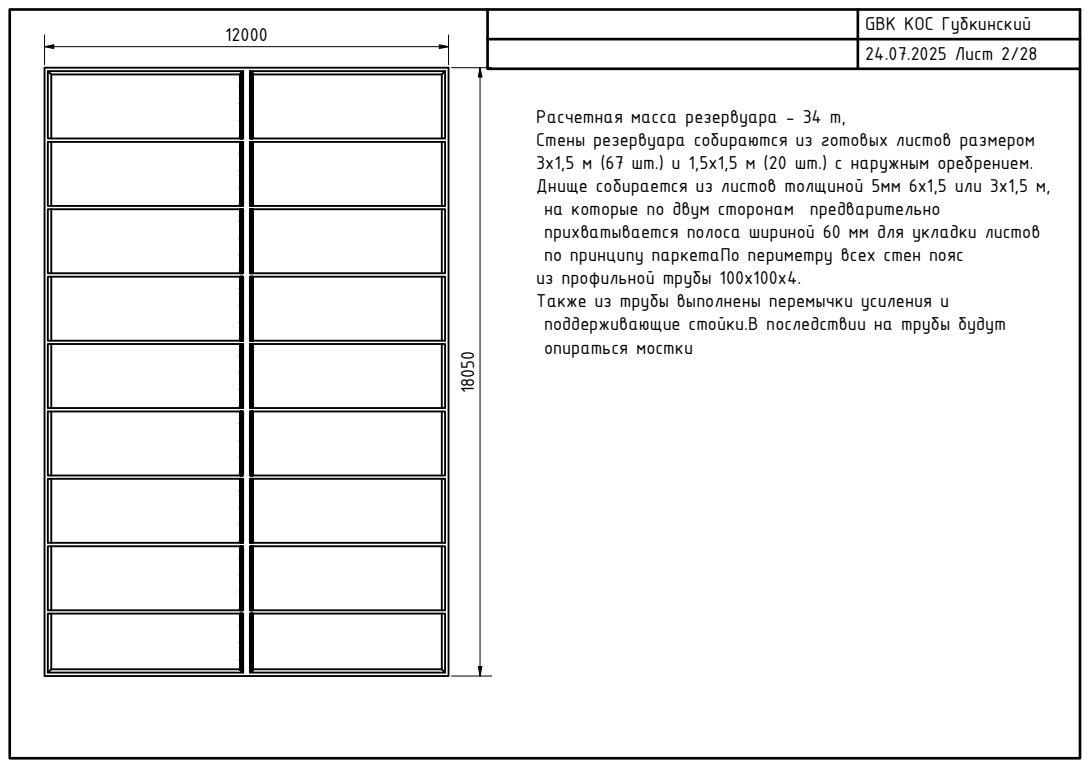
[picture p66: page 2]

Расчетная масса резервуара - 34 т,
Стены резервуара собираются из готовых листов размером
3х1,5 м (67 шт.) и 1,5х1,5 м (20 шт.) с наружным оребрением.
Днище собирается из листов толщиной 5мм 6х1,5 или 3х1,5 м,
на которые по двум сторонам предварительно
прихватывается полоса шириной 60 мм для укладки листов
по принципу паркетаПо периметру всех стен пояс
из профильной трубы 100х100х4.
Также из трубы выполнены перемычки усиления и
поддерживающие стойки.В последствии на трубы будут
опираться мостки

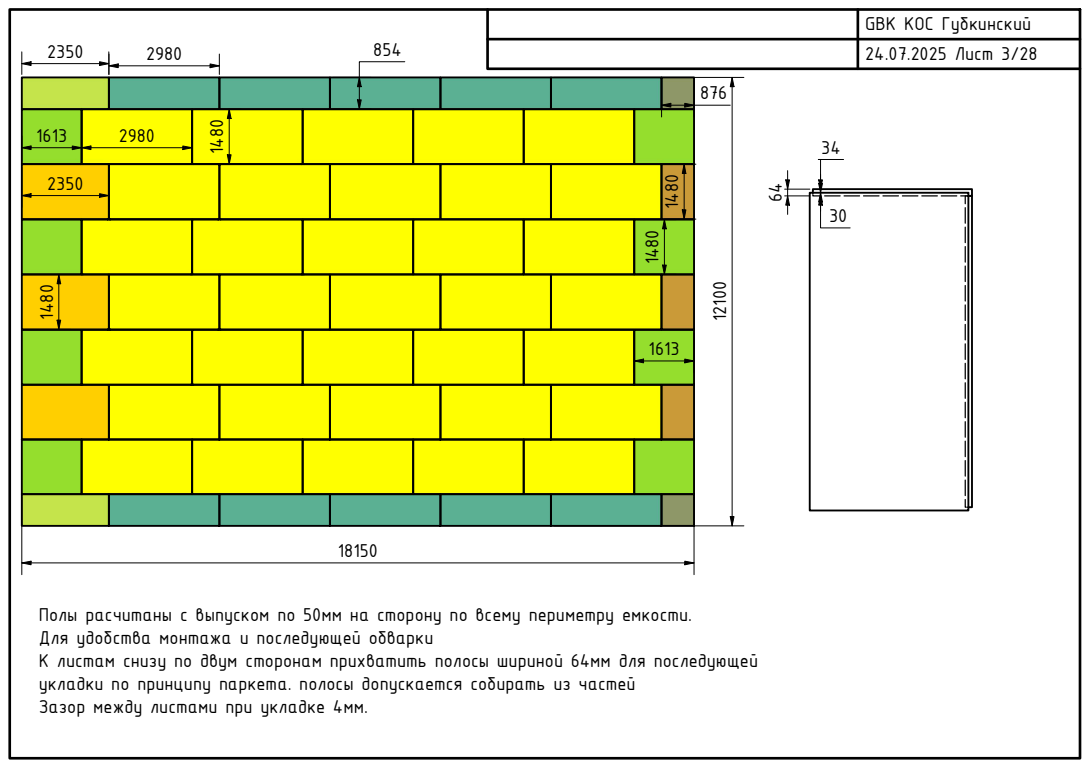
[picture p67: page 3]

Полы расчитаны с выпуском по 50мм на сторону по всему периметру емкости.
Для удобства монтажа и последующей обварки
К листам снизу по двум сторонам прихватить полосы шириной 64мм для последующей
укладки по принципу паркета. полосы допускается собирать из частей
Зазор между листами при укладке 4мм.

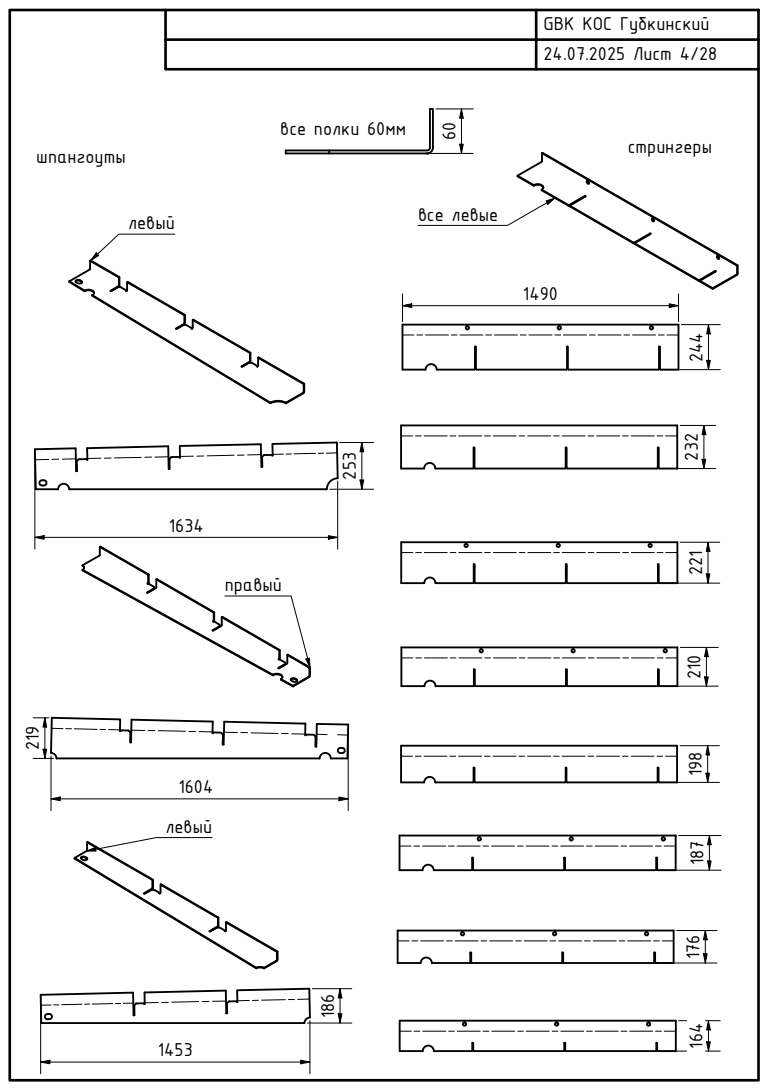
[picture p68: page 4]
все левые; все полки 60мм

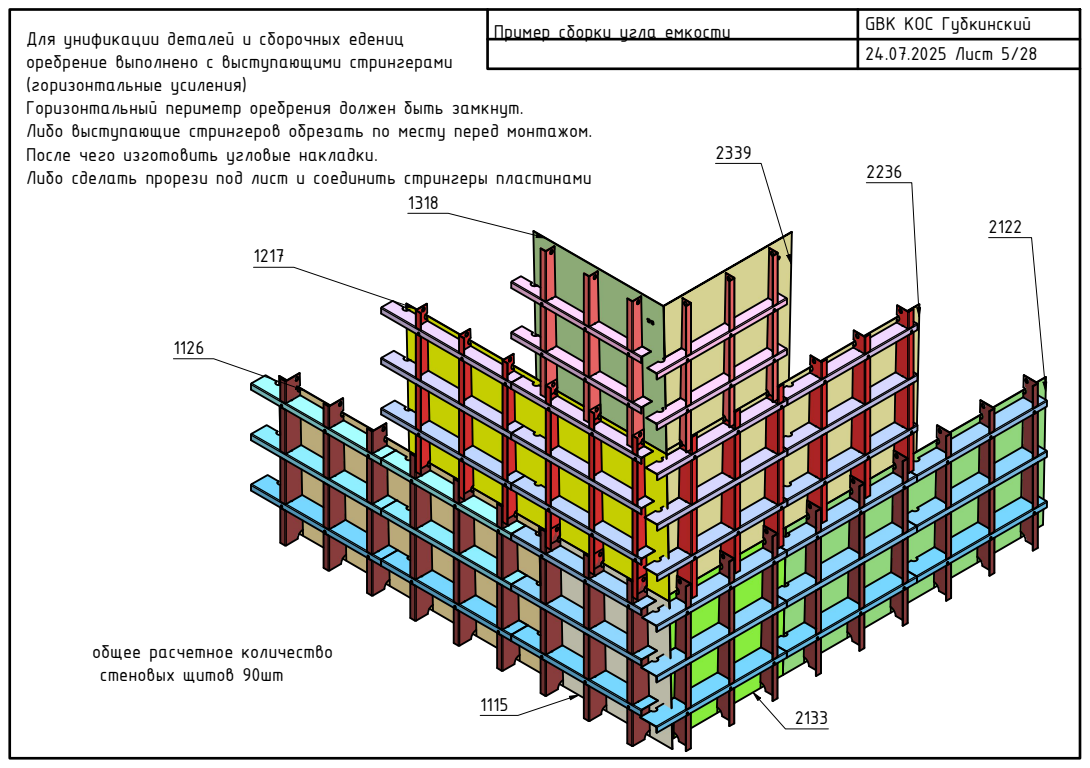
[picture p69: page 5]

Пример сборки угла емкости Для унификации деталей и сборочных едениц
оребрение выполнено с выступающими стрингерами
(горизонтальные усиления)
Горизонтальный периметр оребрения должен быть замкнут.
Либо выступающие стрингеров обрезать по месту перед монтажом.
После чего изготовить угловые накладки.
Либо сделать прорези под лист и соединить стрингеры пластинами

общее расчетное количество
стеновых щитов 90шт

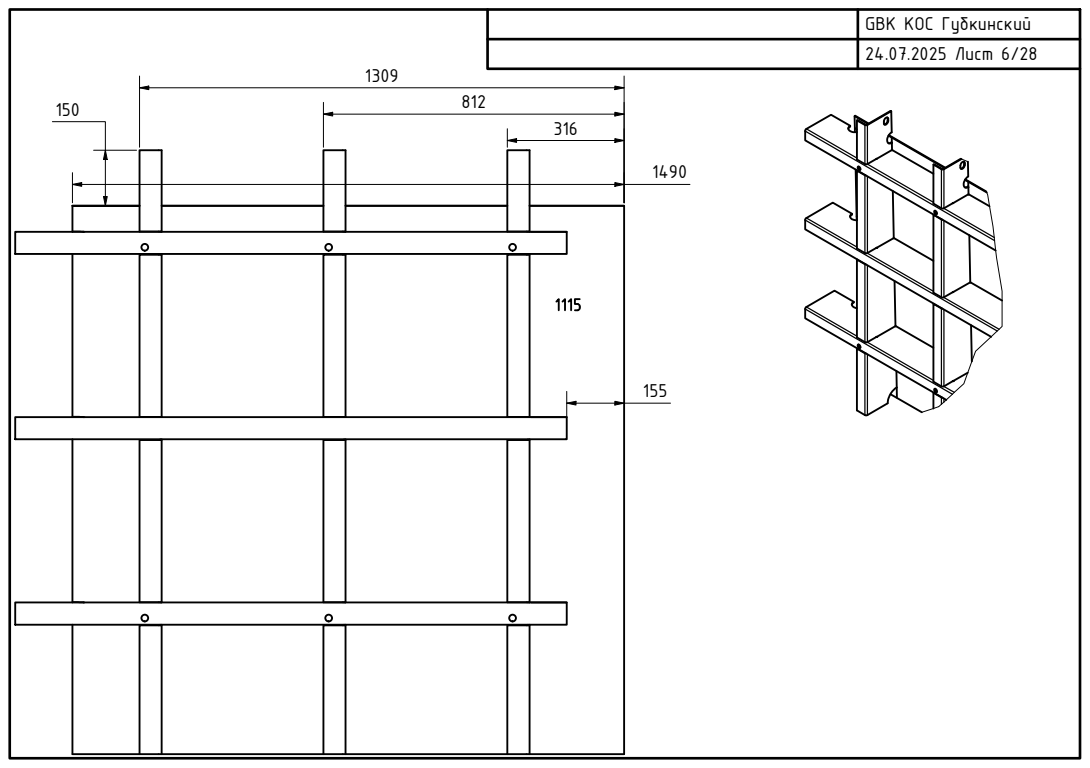
[picture p70: page 6]

G B K К О С Г у б к и н с к и й
2 4.0 7.2 0 2 5 Л и с т 6 / 2 8

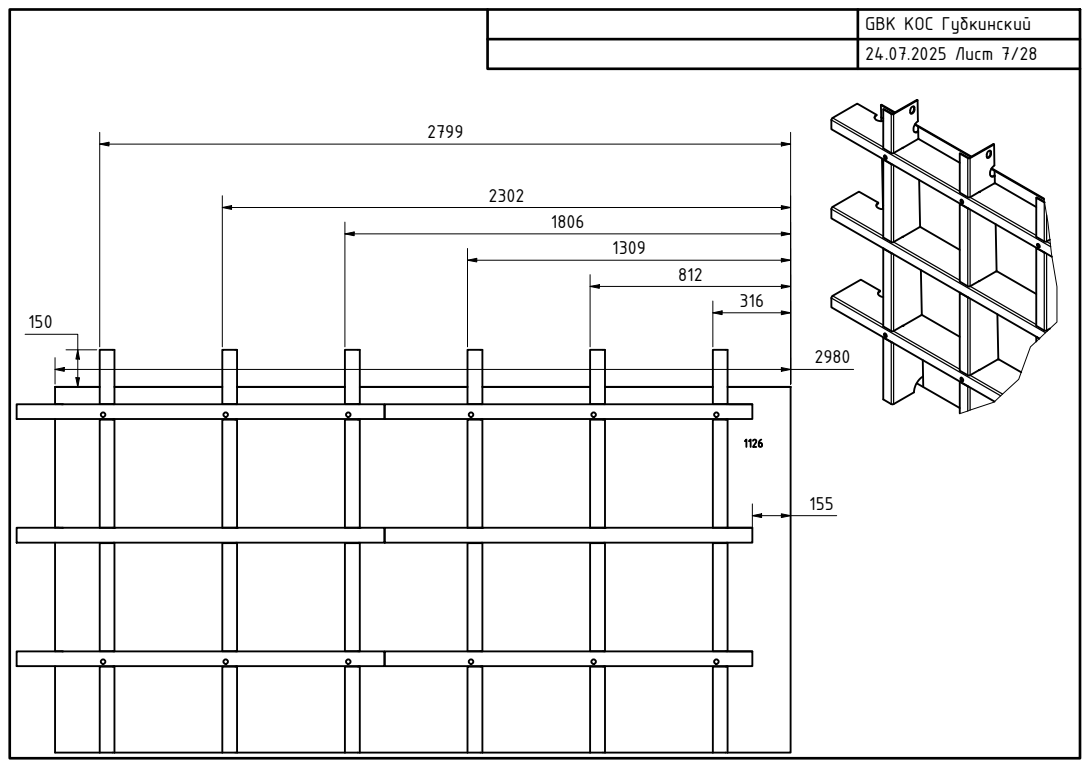
[picture p71: page 7]

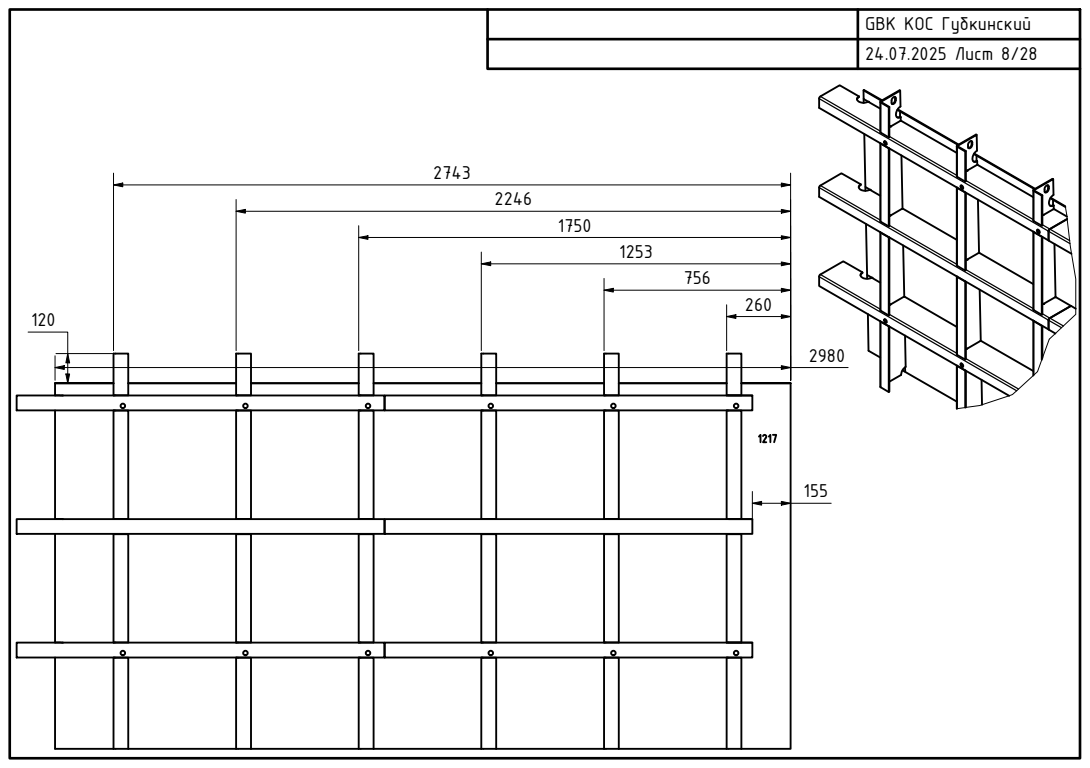
[picture p72: page 8]

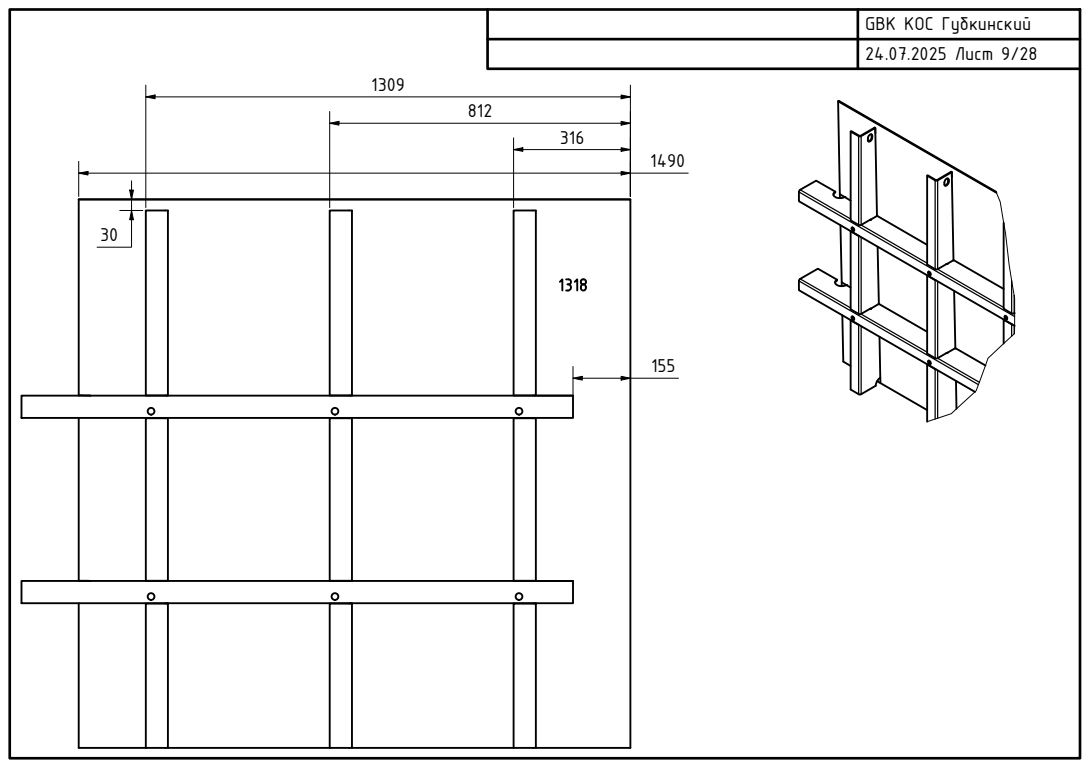
[picture p73: page 9]

G B K К О С Г у б к и н с к и й
2 4.0 7.2 0 2 5 Л и с т 9 / 2 8

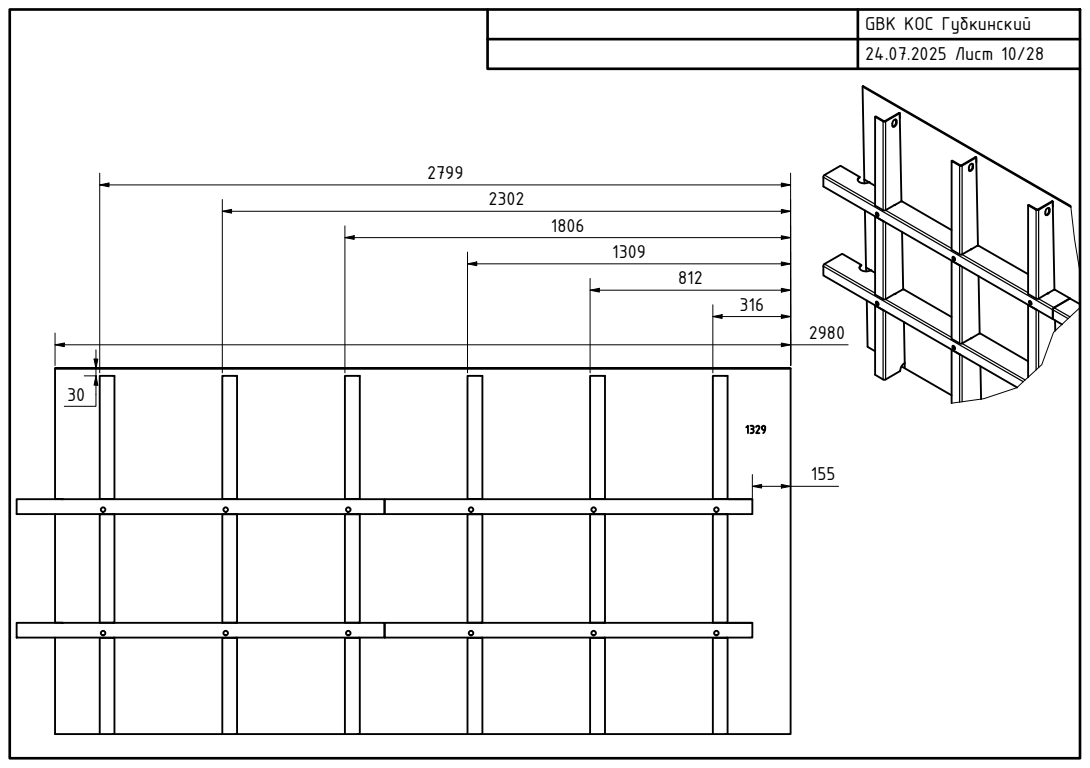
[picture p74: page 10]

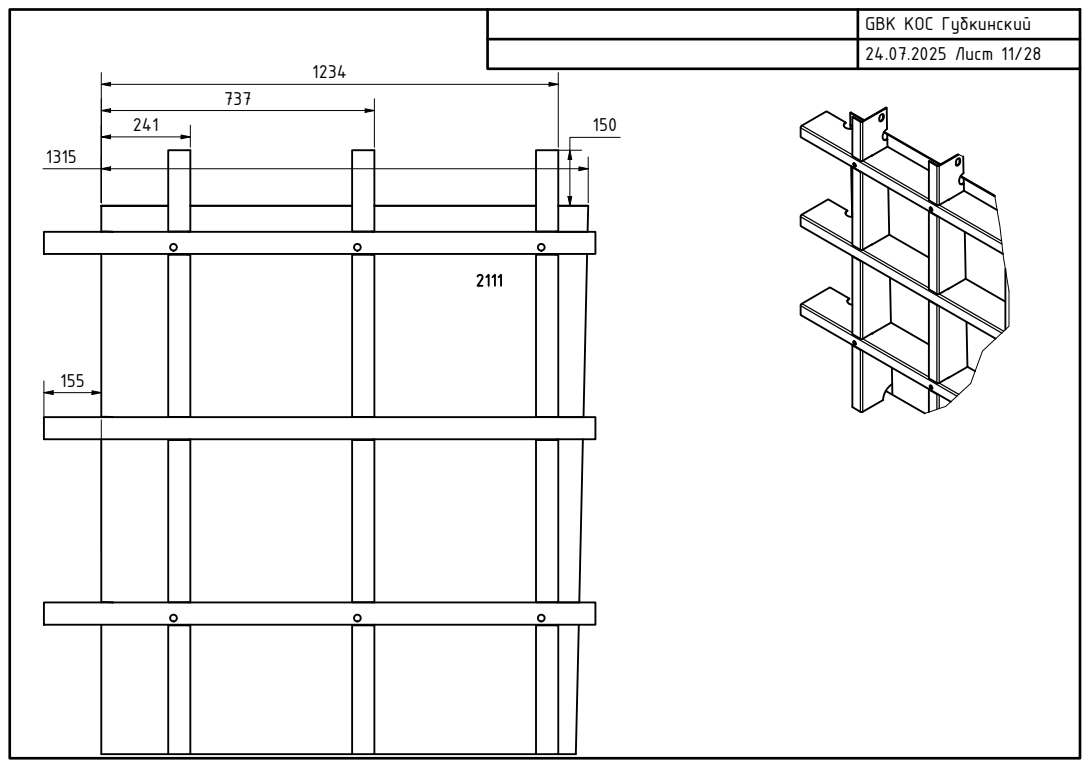
[picture p75: page 11]

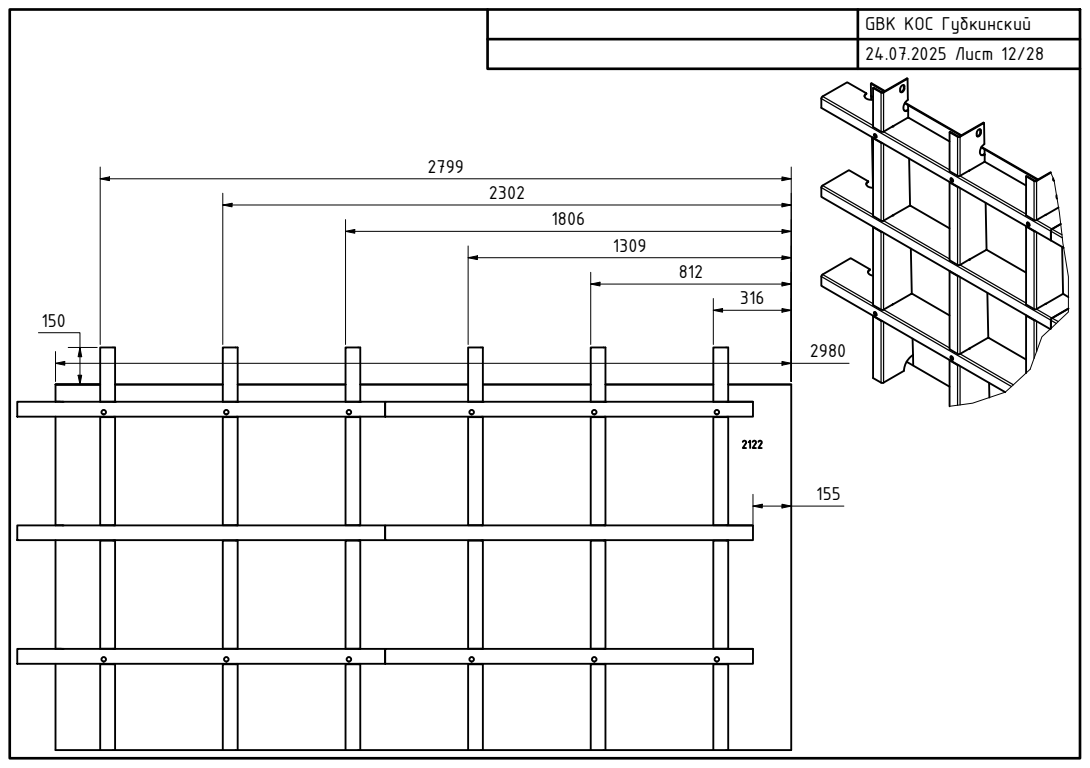
[picture p76: page 12]

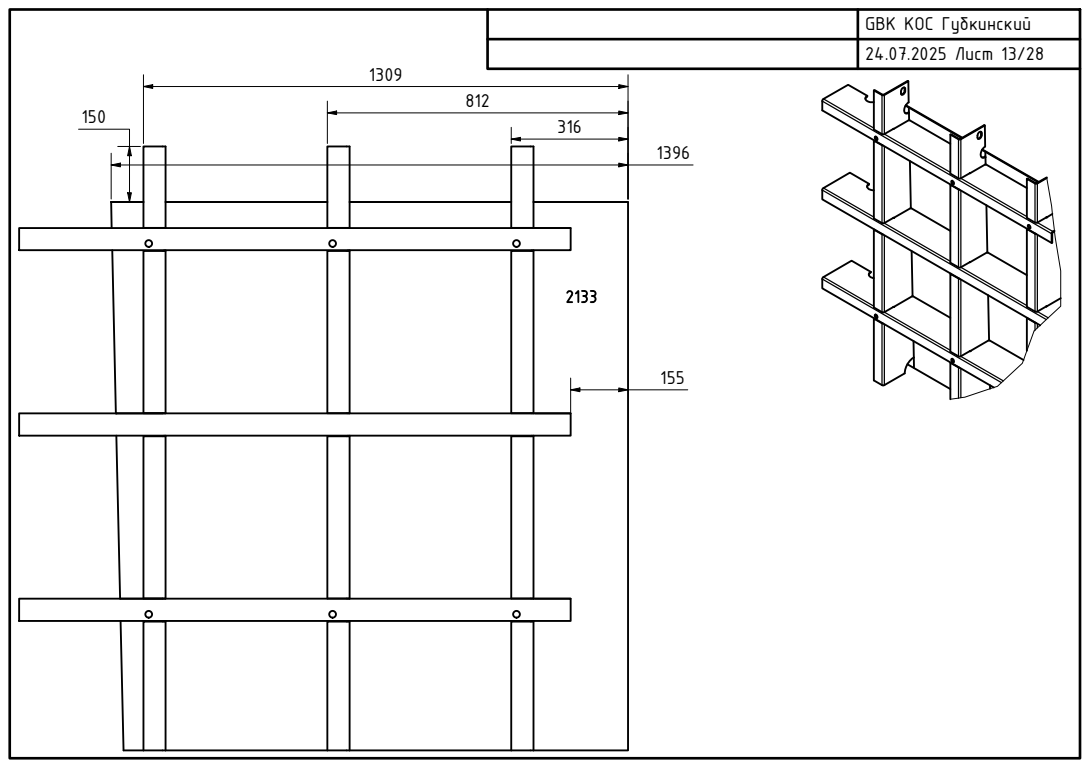
[picture p77: page 13]

G B K К О С Г у б к и н с к и й
2 4.0 7.2 0 2 5 Л и с т 1 3 / 2 8

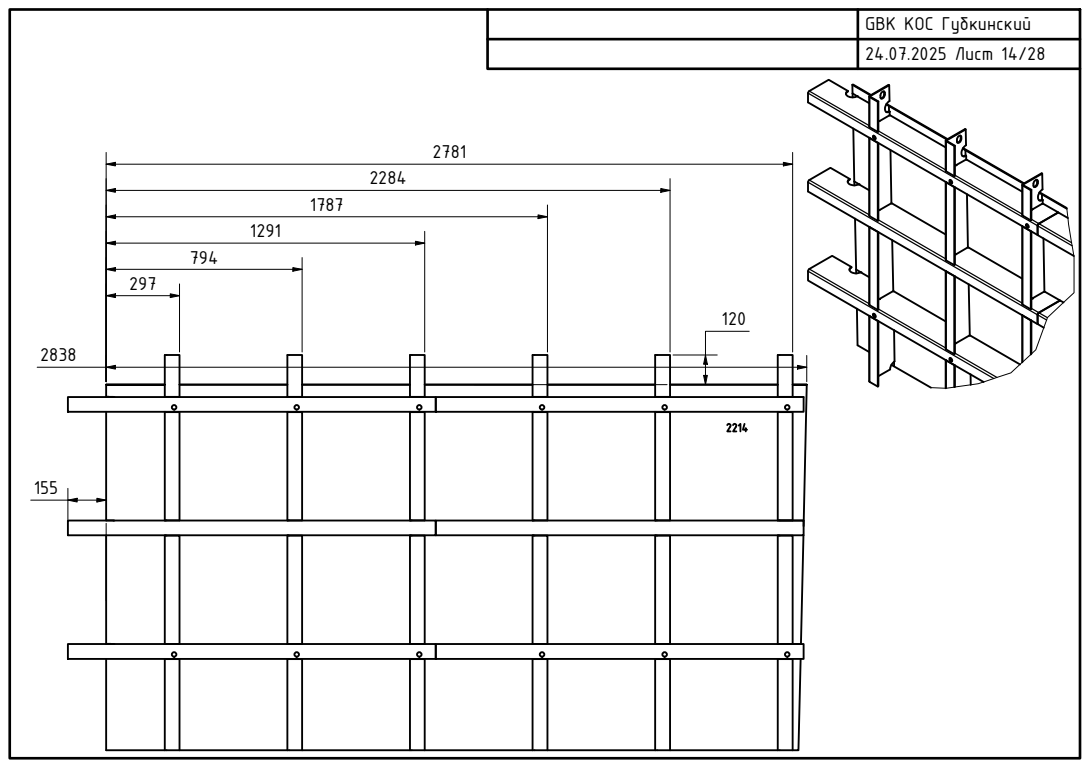
[picture p78: page 14]

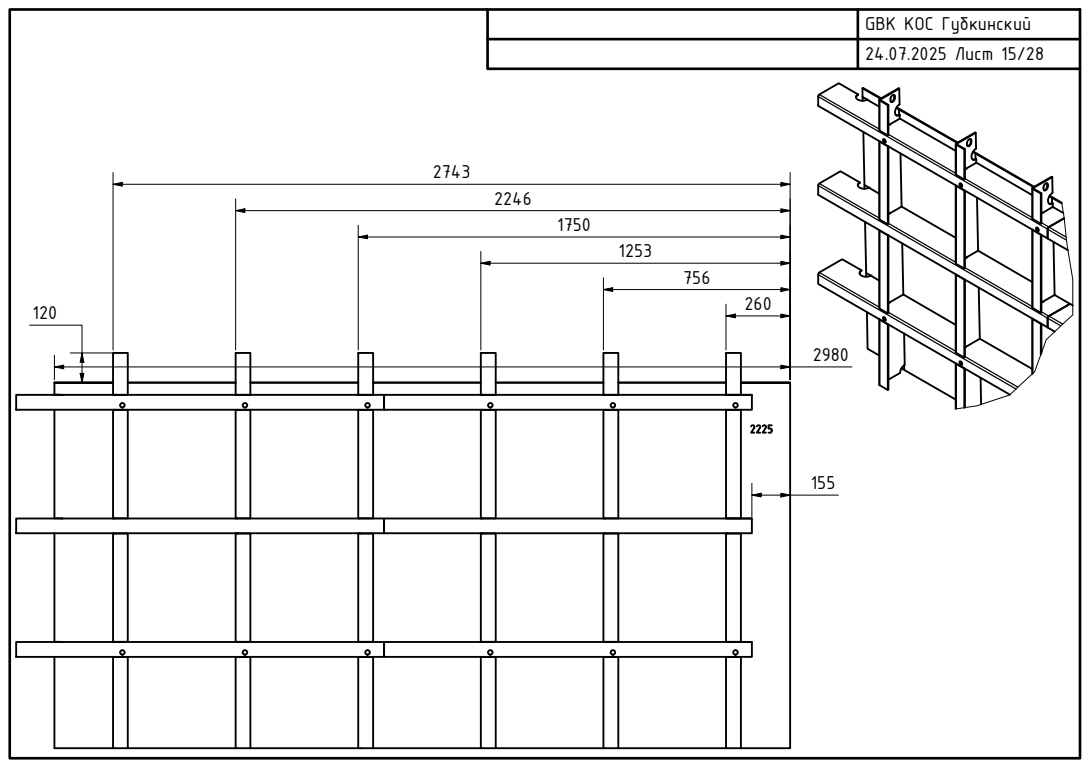
[picture p79: page 15]

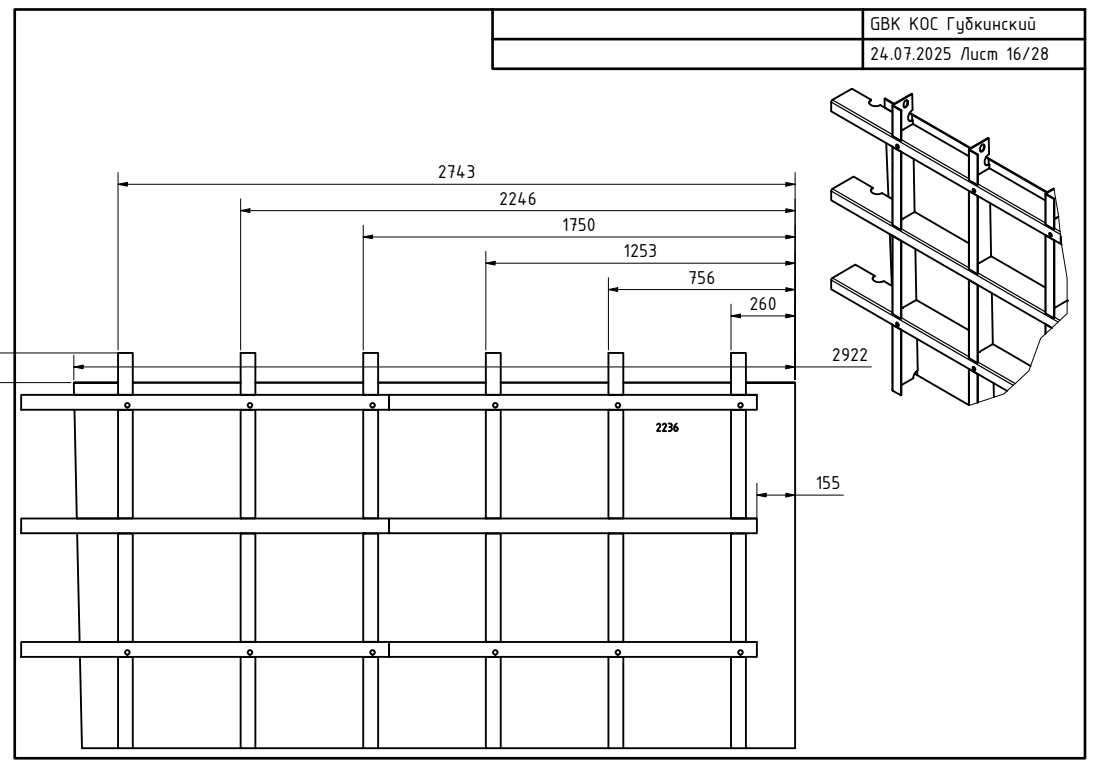
[picture p80: page 16]

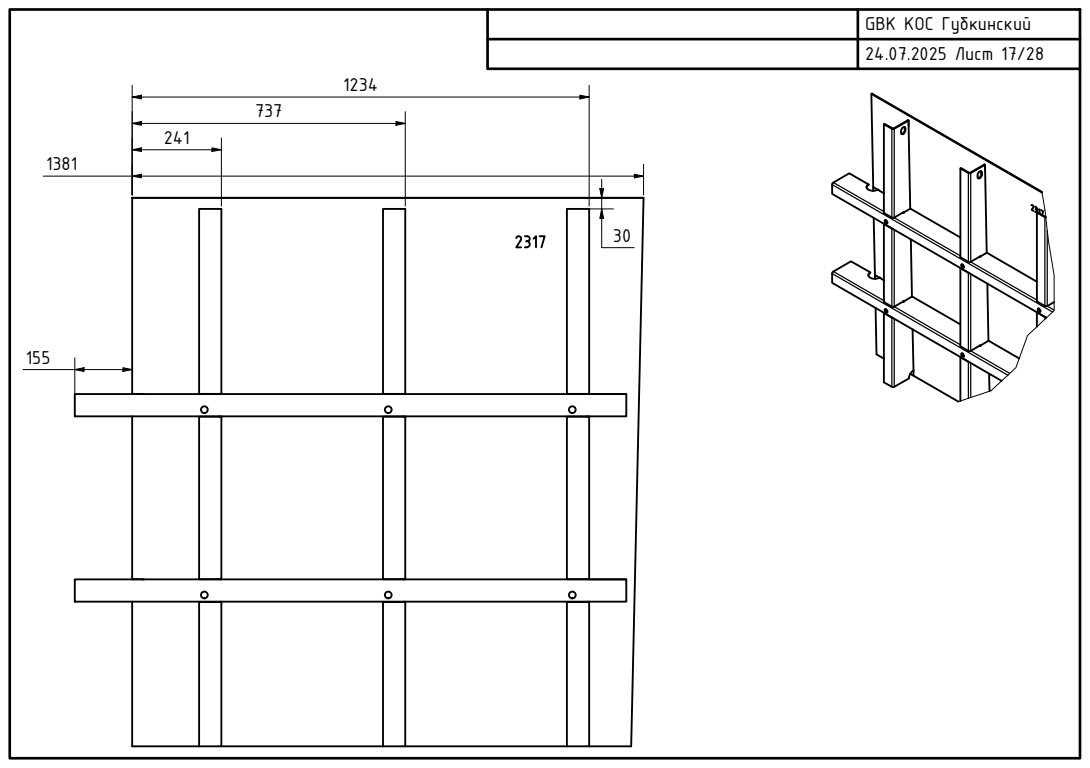
[picture p81: page 17]

G B K К О С Г у б к и н с к и й
2 4.0 7.2 0 2 5 Л и с т 1 7 / 2 8

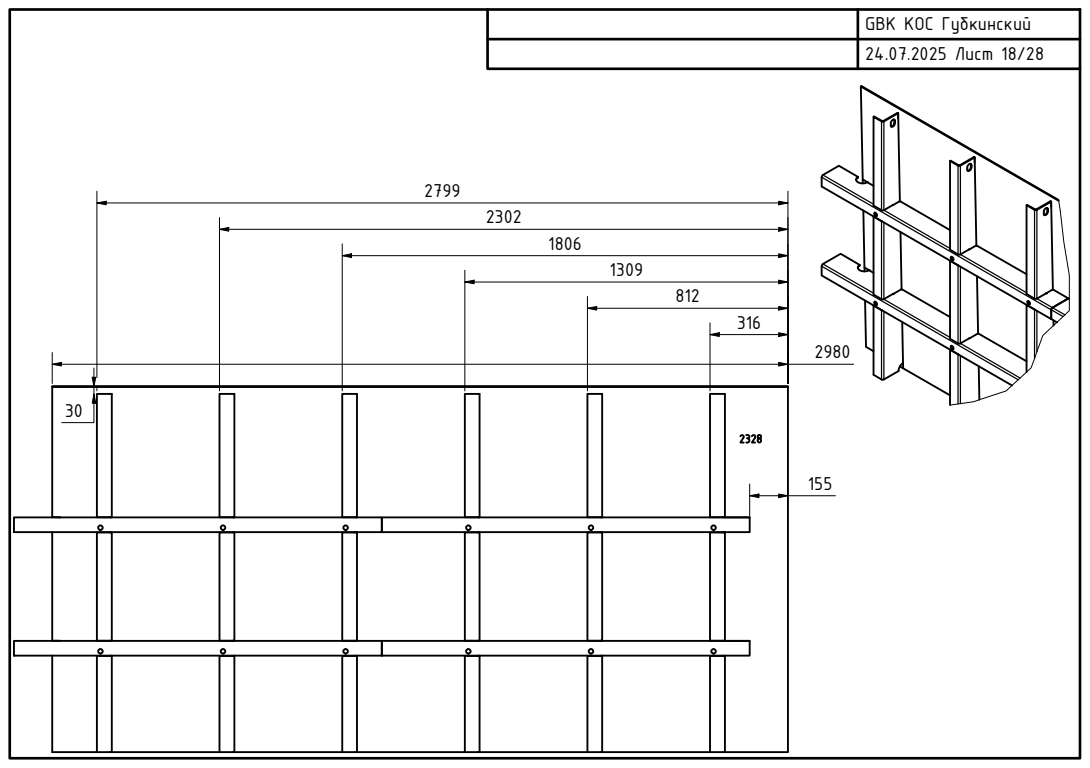
[picture p82: page 18]

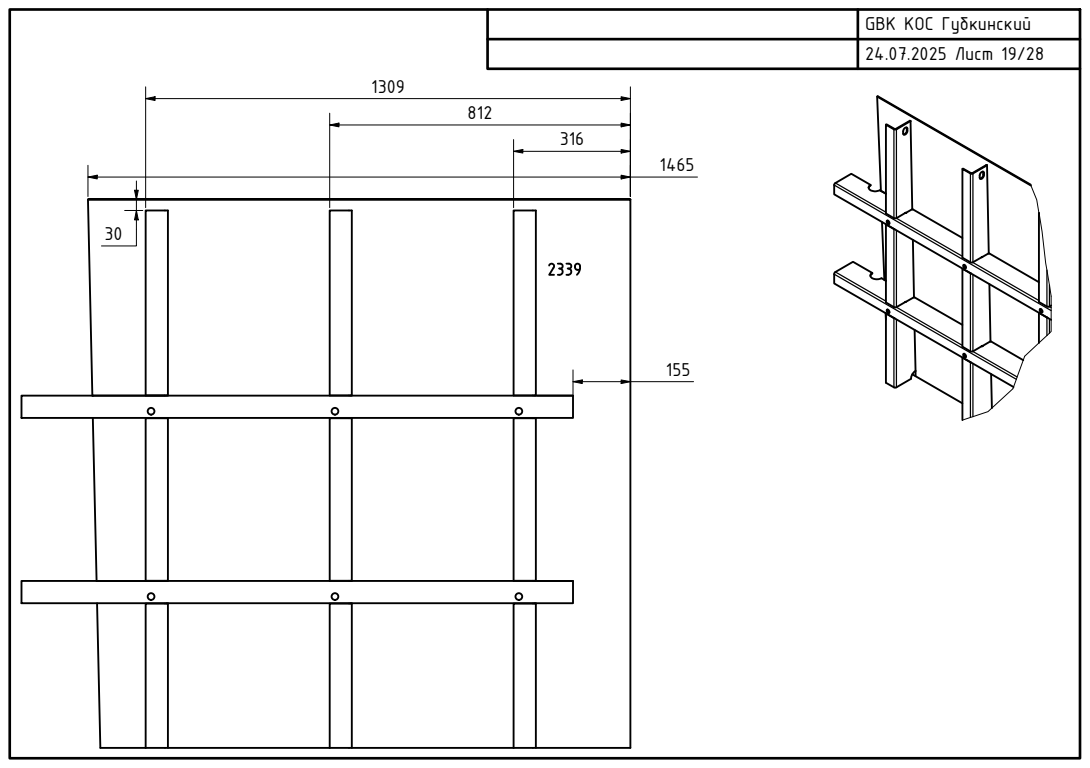
[picture p83: page 19]

G B K К О С Г у б к и н с к и й
2 4.0 7.2 0 2 5 Л и с т 1 9 / 2 8

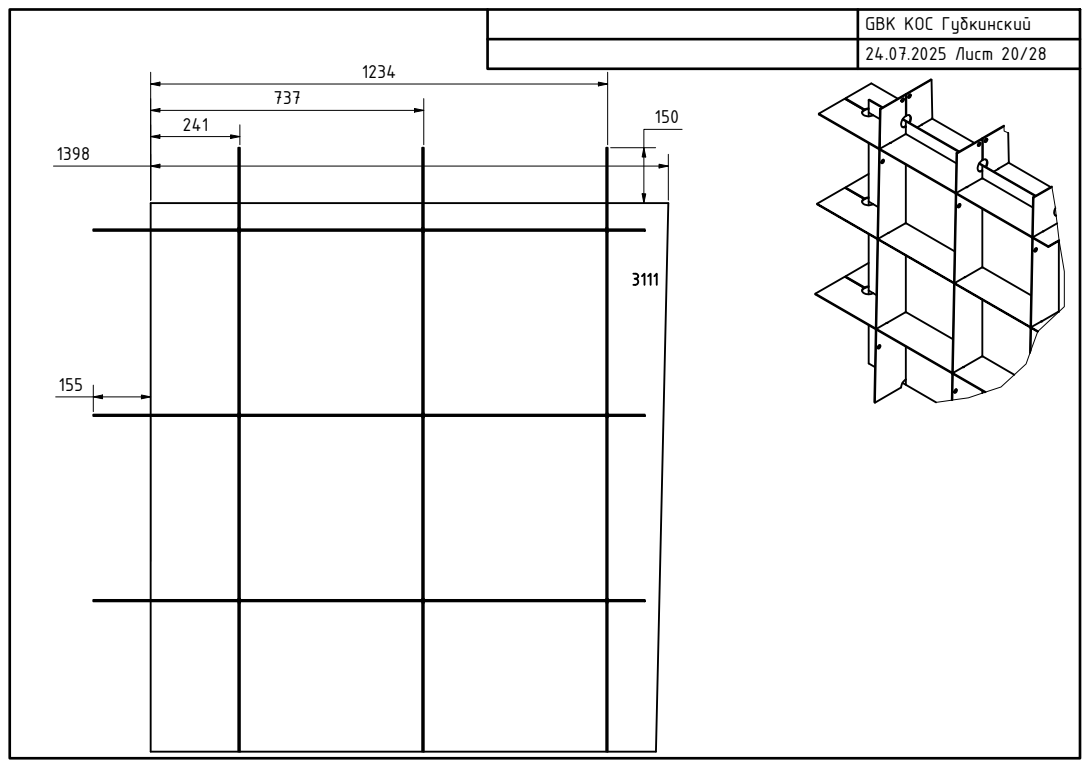
[picture p84: page 20]

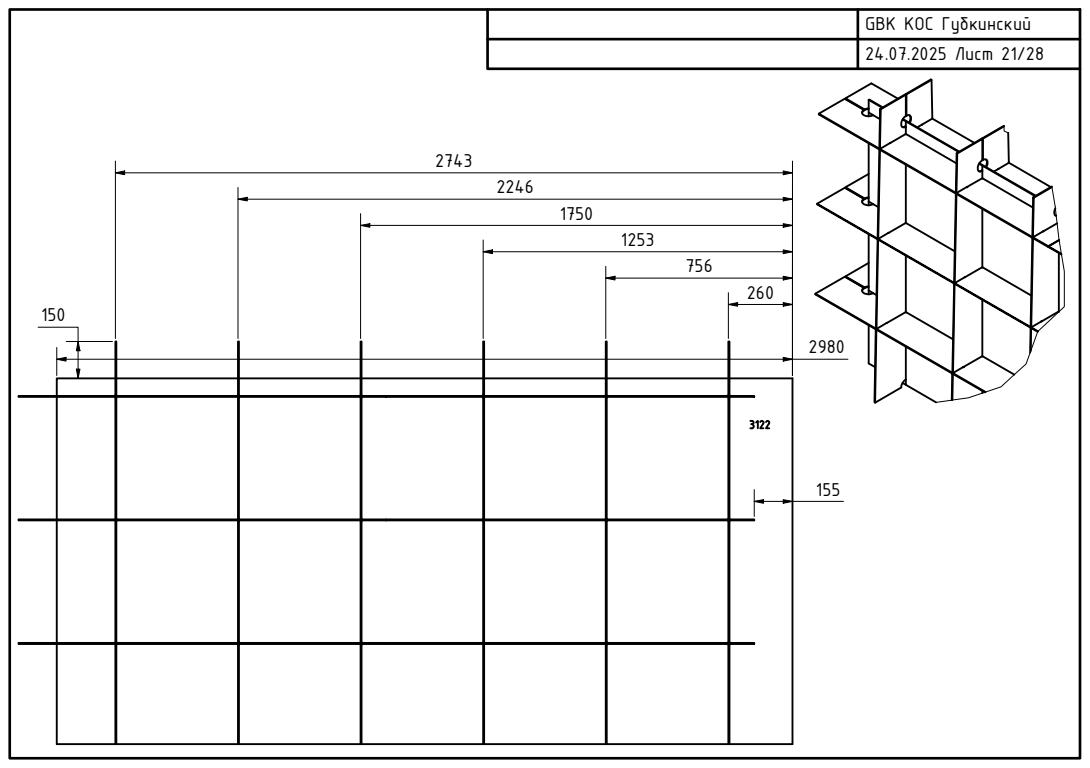
[picture p85: page 21]

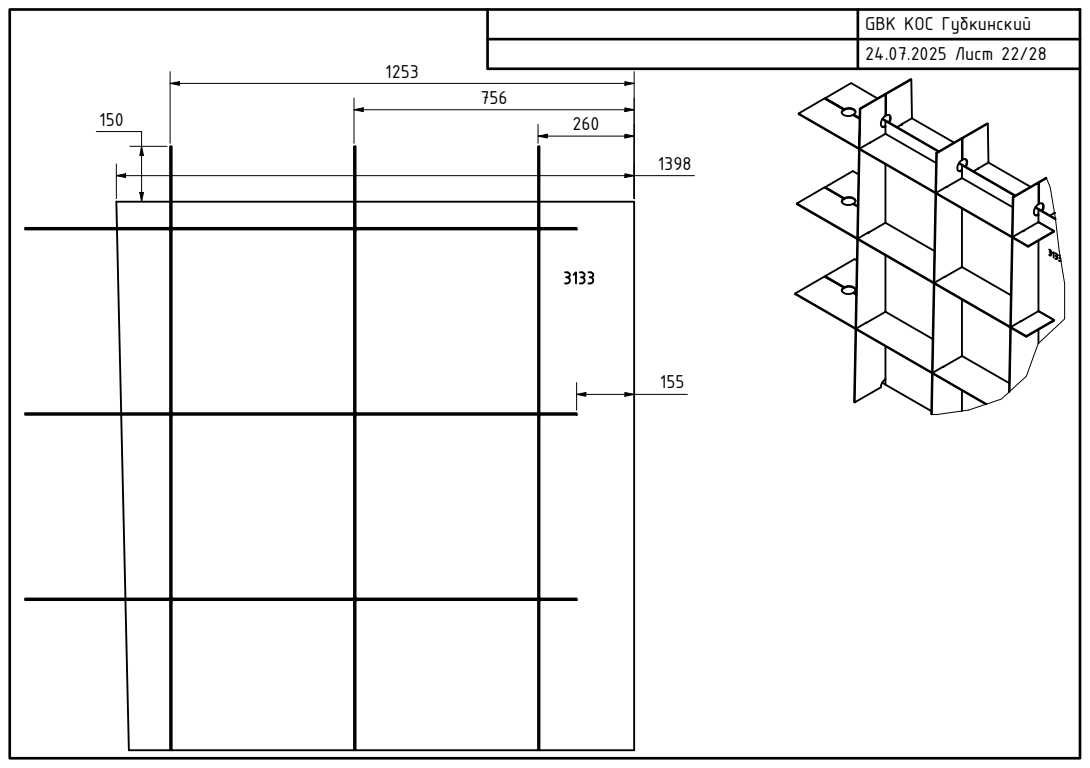
[picture p86: page 22]

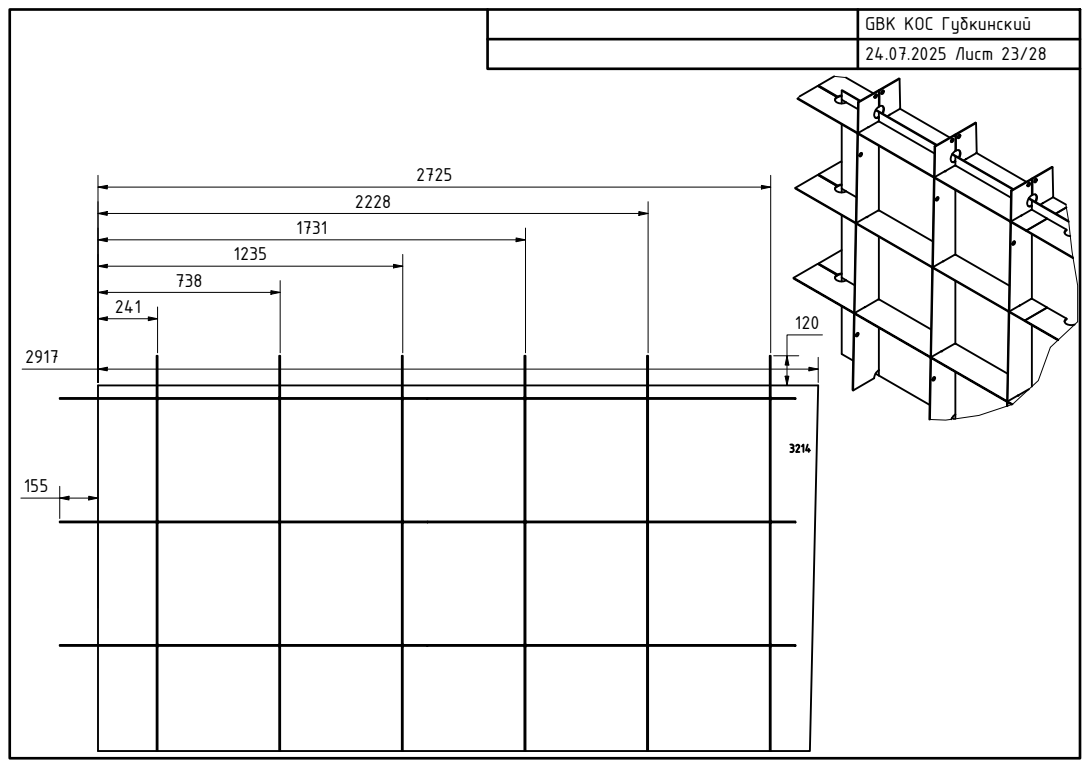
[picture p87: page 23]

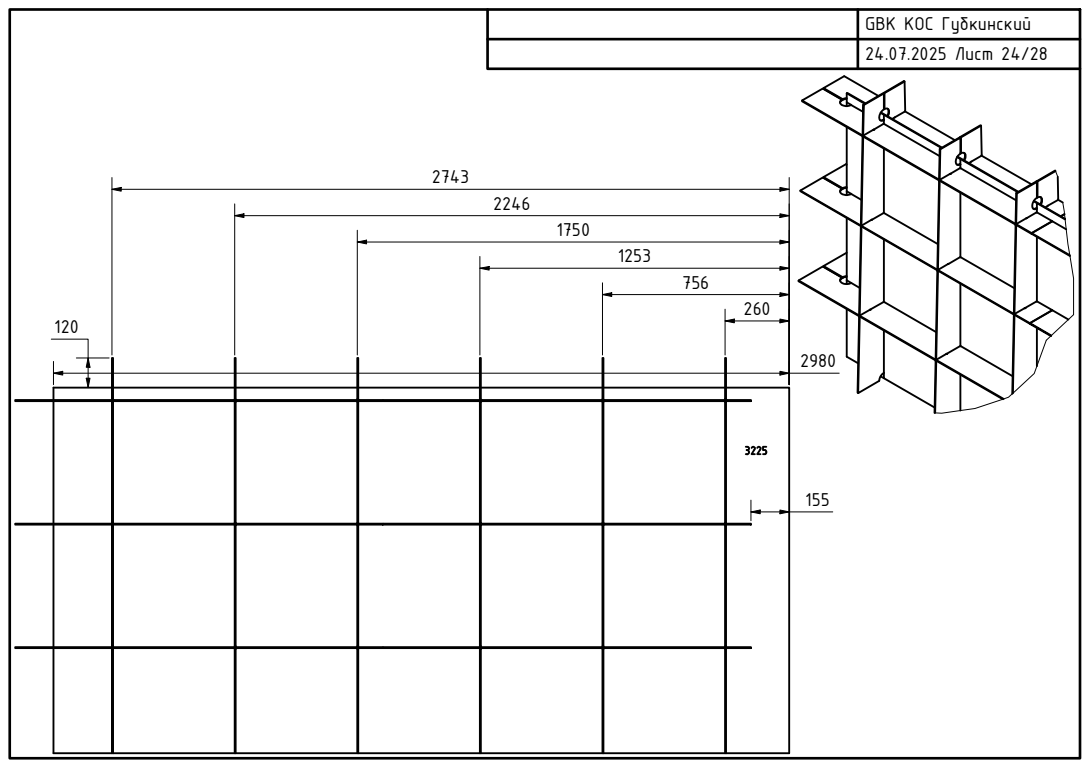
[picture p88: page 24]

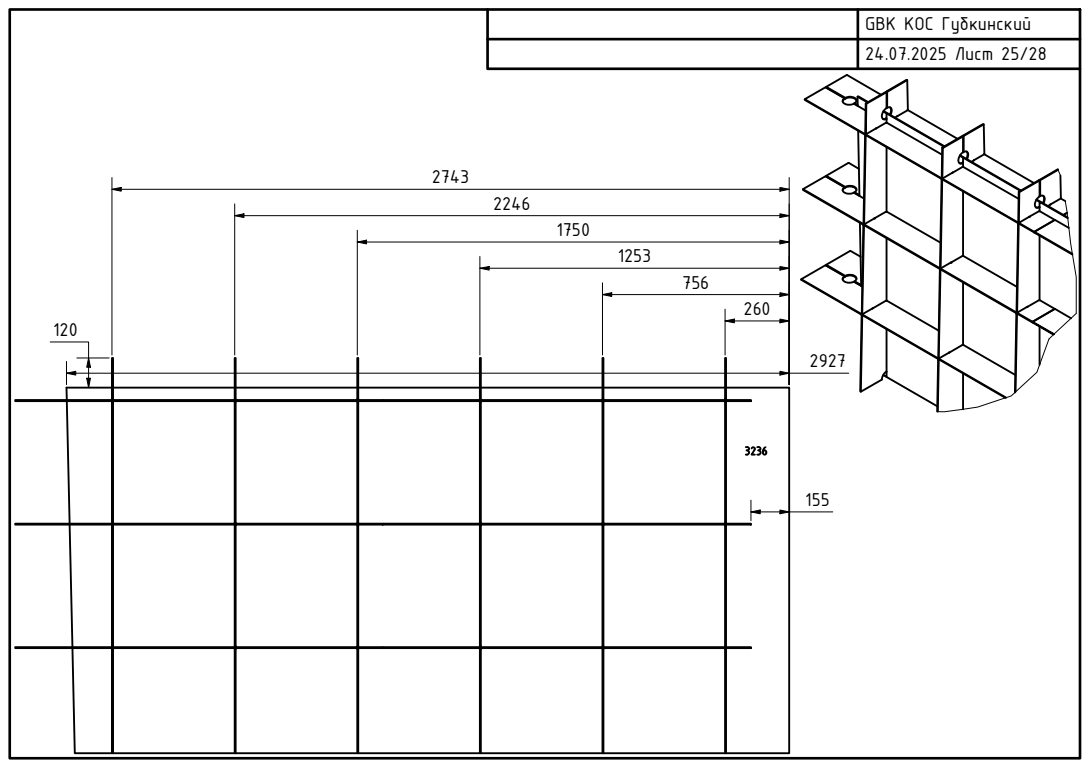
[picture p89: page 25]

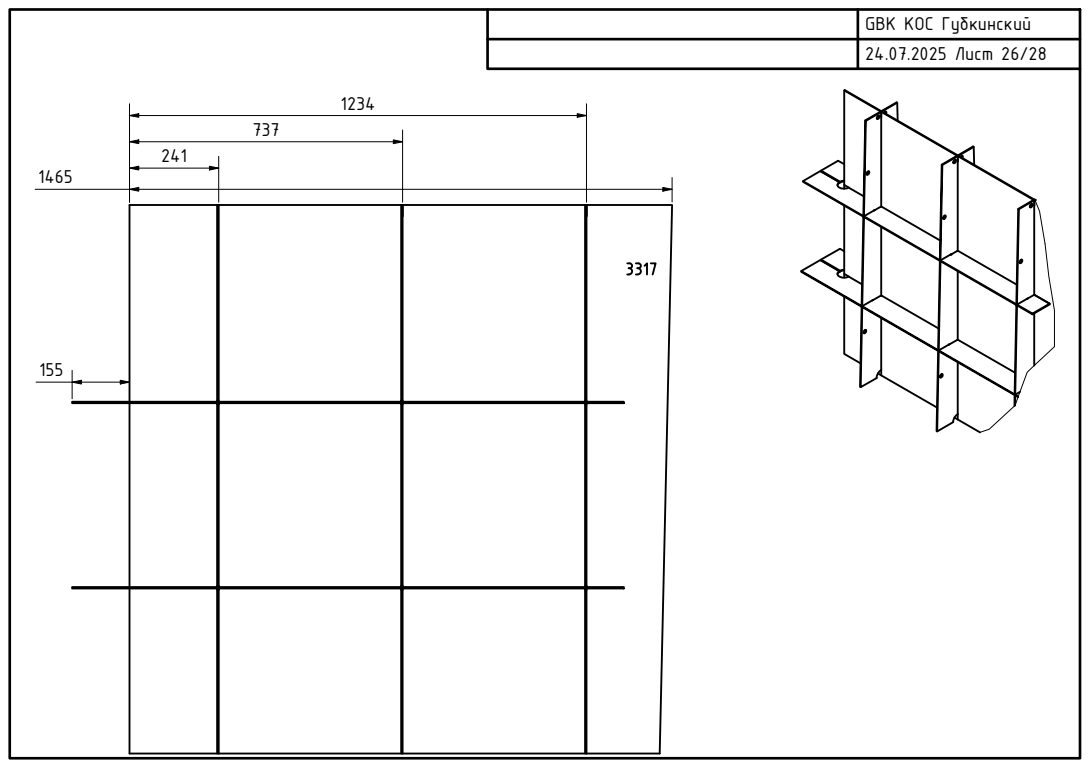
[picture p90: page 26]

G B K К О С Г у б к и н с к и й
2 4.0 7.2 0 2 5 Л и с т 2 6 / 2 8

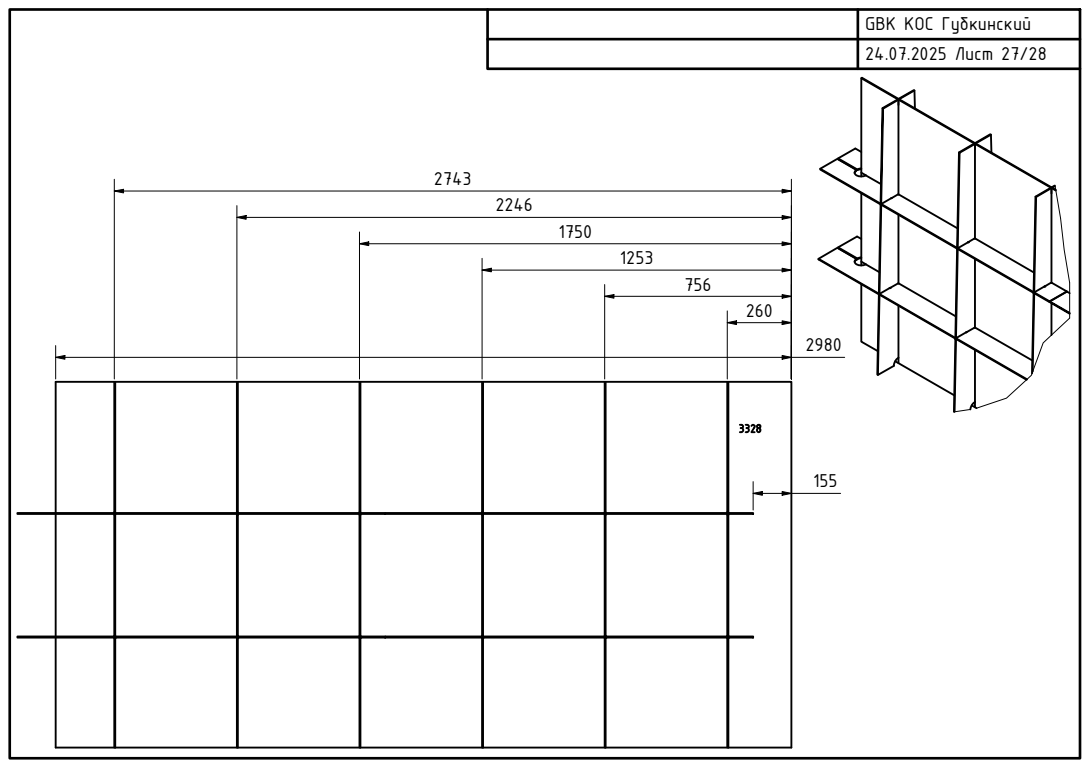
[picture p91: page 27]

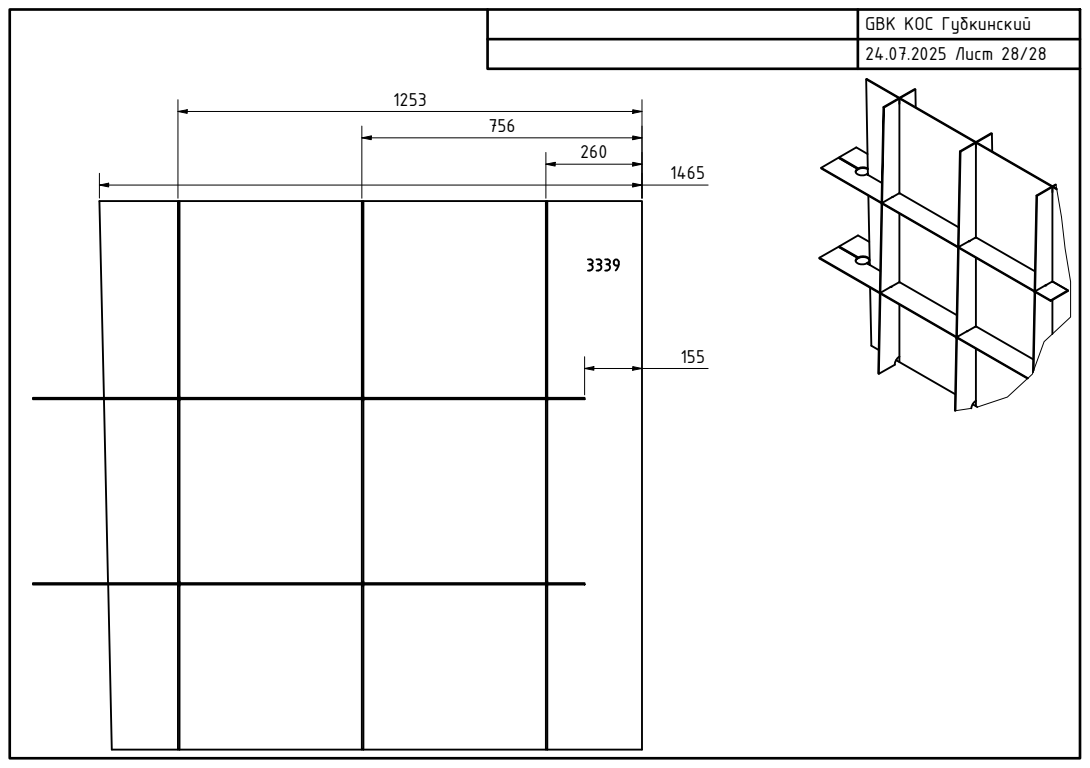
[picture p92: page 28]
