bigstrongbeast/GBK-Gubkinskiy/GBK Чертеж 1й сборки по полу.pdf

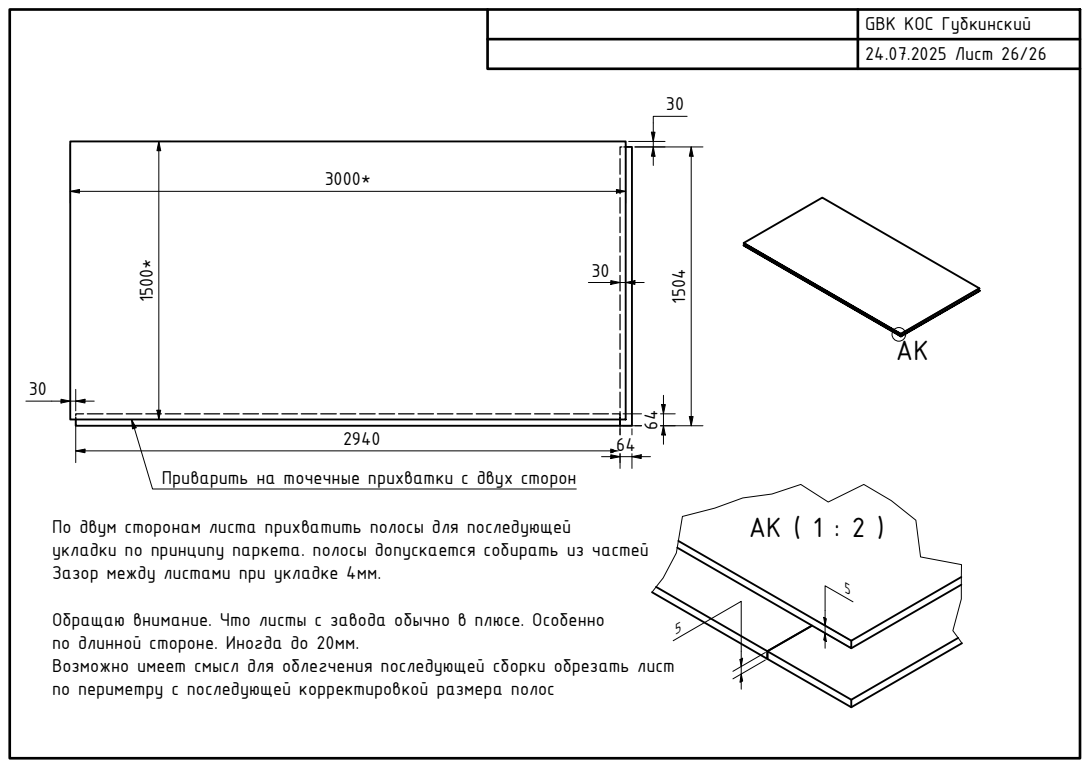
[picture p93: page 1]

GBK КОС Губкинский
24.07.2025 Лист 26/26

Приварить на точечные прихватки с двух сторон

По двум сторонам листа прихватить полосы для последующей
укладки по принципу паркета. полосы допускается собирать из частей
Зазор между листами при укладке 4мм.

Обращаю внимание. Что листы с завода обычно в плюсе. Особенно
по длинной стороне. Иногда до 20мм.
Возможно имеет смысл для облегчения последующей сборки обрезать лист
по периметру с последующей корректировкой размера полос
