bigstrongbeast/GBK-Gubkinskiy/(commit log)

2026-04-17 пробник
    [Assembly1.iam, Assembly1.stp, Part1.ipt, Part111.ipt, Part2.0001.ipt, Part2.ipt, Part2_CPY.ipt, Part2_CPY_CPY.ipt]
2026-04-24 голобальный старт
    [Assembly1.0001.iam, Assembly1.iam, Part2.0001.ipt, Part2.0002.ipt, Part2.ipt, Part3.ipt]
2026-05-12 разработка стыков
    Прочитать госты решить соединение по полу, сделать раскладку. решить подрезку по периметру
    [Assembly shield 1.0001.iam, Assembly shield 1.0002.iam, Assembly shield 1.iam, Assembly1.0006.iam, Assembly1.0009.iam, Assembly1.iam, Part1.0002.ipt, Part1.0004.ipt]
2026-05-12 Глеб
    Тест
2026-05-12 Глеб
    Сварка
2026-05-13 Стартуем ренейминг
    [Assembly shield 1.0002.iam, Assembly shield 1.0007.iam, Assembly shield 1.iam, Assembly shield 1_CPY2.0002.iam, Assembly shield 1_CPY2.0003.iam, Assembly shield 1_CPY2.iam, Assembly1.0009.iam, Assembly1.0013.iam]
2026-05-14 Глеб
    Навел порядок в наименовании и структуре
    [000 ASY GBK Gubkinskiy.0017.iam, 000 ASY GBK Gubkinskiy.iam, 01 ASY GBK wall shield 1.1.1.iam, 01.1 GBK shield.ipt, 01.2 GBK main rib.ipt, 01.3 GBK stringer.ipt, Assembly shield 1.0007.iam, Assembly shield 1.iam]
2026-05-17 Глеб
    Сделал примитивную емкость со стенкой и разложил примерно листы. Для Михаила
    [000 ASY GBK Gubkinskiy.0017.iam, 000 ASY GBK Gubkinskiy.0018.iam, 000 ASY GBK Gubkinskiy.iam, GBK bottom.0008.ipt, GBK bottom.ipt, GBK overall model.0005.ipt, GBK overall model.ipt]
2026-05-17 Глеб
    Присвоил все имена. Настроил зависимости.
    [000 ASY GBK Gubkinskiy.0018.iam, 000 ASY GBK Gubkinskiy.0019.iam, 000 ASY GBK Gubkinskiy.iam, 01 ASY GBK wall shield 1.1.1.0012.iam, 01 ASY GBK wall shield 1.1.1.0012_1.iam, 01 ASY GBK wall shield 1.1.1.iam, 01.1 GBK shield.0004.ipt, 01.1 GBK shield.ipt]
2026-05-18 шпангоуты вариант 4
    [000 ASY GBK Gubkinskiy.0019.iam, 000 ASY GBK Gubkinskiy.0021.iam, 000 ASY GBK Gubkinskiy.iam, 01 ASY GBK wall shield 1.1.1.0012.iam, 01 ASY GBK wall shield 1.1.1.0012_1.iam, 01 ASY GBK wall shield 1.1.1.0013.iam, 01 ASY GBK wall shield 1.1.1.iam, 01.1 GBK shield.0004.ipt]
2026-05-18 сделать стрингеры сделать 5 сборок по боковой стенке
    [000 ASY GBK Gubkinskiy.0021.iam, 000 ASY GBK Gubkinskiy.0023.iam, 000 ASY GBK Gubkinskiy.iam, 01 ASY GBK wall shield 1.1.1.0013.iam, 01 ASY GBK wall shield 1.1.1.0015.iam, 01 ASY GBK wall shield 1.1.1.iam, 01.1 GBK shield.0005.ipt, 01.1 GBK shield.0006.ipt]
2026-05-18 Глеб
    5 первых параметрических стенок
    [000 ASY GBK Gubkinskiy.0023.iam, 000 ASY GBK Gubkinskiy.0027.iam, 000 ASY GBK Gubkinskiy.iam, 01 ASY GBK wall shield 1.1.1.0015.iam, 01 ASY GBK wall shield 1.1.1.0016.iam, 01 ASY GBK wall shield 1.1.1.iam, 01.1 GBK shield_CPY.ipt, 0121 GBK shield 2.ipt]
2026-05-19 собрал боковую стенку. начал центральную
    [000 ASY GBK Gubkinskiy.0027.iam, 000 ASY GBK Gubkinskiy.0033.iam, 000 ASY GBK Gubkinskiy.iam, 01 ASY GBK wall shield 1.1.1.0016.iam, 01 ASY GBK wall shield 1.1.1.0024.iam, 01 ASY GBK wall shield 1.1.1.iam, 01.1 GBK shield.0006.ipt, 01.1 GBK shield.0007.ipt]
2026-05-19 Миша
    Создал набор дна
    [090 ASY bottom.0005.iam, 090 ASY bottom.iam, 0910.0002.ipt, 0910.ipt, 092.iam, 0921.0001.ipt, 0921.ipt, 0921_CPY.0001.ipt]
2026-05-19 Глеб
    Поправил стрингеры на внешних стенках. сделал Заготовки под внутреннюю стенку
    [000 ASY GBK Gubkinskiy.0033.iam, 000 ASY GBK Gubkinskiy.0035.iam, 000 ASY GBK Gubkinskiy.iam, 01 ASY GBK wall shield 1.1.1.0024.iam, 01 ASY GBK wall shield 1.1.1.0025.iam, 01 ASY GBK wall shield 1.1.1.iam, 010.7 GBK shield.ipt, 01001 ASY GBK wall shield Center 10.iam]
2026-05-20 рефакторинг
    [000 ASY GBK Gubkinskiy.0035.iam, 000 ASY GBK Gubkinskiy.0038.iam, 000 ASY GBK Gubkinskiy.iam, 01 ASY GBK wall shield 1.1.1.0025.iam, 01 ASY GBK wall shield 1.1.1.0026.iam, 01 ASY GBK wall shield 1.1.1.0027.iam, 01 ASY GBK wall shield 1.1.1.iam, 01.1 GBK shield.0007.ipt]
2026-05-21 дороге мироздание намекает мне не выебываться
    [000 ASY GBK Gubkinskiy.0038.iam, 000 ASY GBK Gubkinskiy.0040.iam, 000 ASY GBK Gubkinskiy.0040_1.iam, 000 ASY GBK Gubkinskiy.iam, 010.7 GBK shield.0001.ipt, 010.7 GBK shield.0002.ipt, 010.7 GBK shield.ipt, 01011 GBK Center rib 3.0001.ipt]
2026-05-21 рефакторинг3
    [000 ASY GBK Gubkinskiy.0040.iam, 000 ASY GBK Gubkinskiy.0040_1.iam, 000 ASY GBK Gubkinskiy.0042.iam, 000 ASY GBK Gubkinskiy.iam, 0241 GBK stringer 4.ipt, 0242 GBK stringer 5.ipt, 0243 GBK stringer 6.ipt, 0371 GBK stringer 7.ipt]
2026-05-21 Глеб
    Переименовал все файлы кроме щитов
    [000 ASY GBK Gubkinskiy.0042.iam, 000 ASY GBK Gubkinskiy.0045.iam, 000 ASY GBK Gubkinskiy.0045_1.iam, 000 ASY GBK Gubkinskiy.iam, 010.7 GBK shield.0003.ipt, 010.7 GBK shield.ipt, 01001 ASY GBK wall shield Center 10.0002.iam, 01001 ASY GBK wall shield Center 10.0003.iam]
2026-05-24 Глеб
    Сделал короткую стенку, угол пока подобрать не смог
    [000 ASY GBK Gubkinskiy.0045.iam, 000 ASY GBK Gubkinskiy.0045_1.iam, 000 ASY GBK Gubkinskiy.0063.iam, 000 ASY GBK Gubkinskiy.0063_1.iam, 000 ASY GBK Gubkinskiy.iam, ASY GBK 1110 long wall shield 1.0030.iam, ASY GBK 1110 long wall shield 1.0030_1.iam, ASY GBK 1110 long wall shield 1.0030_2.iam]
2026-05-25 Ренейминг стенок
    [000 ASY GBK Gubkinskiy.0063.iam, 000 ASY GBK Gubkinskiy.0063_1.iam, 000 ASY GBK Gubkinskiy.0066.iam, 000 ASY GBK Gubkinskiy.iam, 07.1 GBK shield.0004.ipt, 07.1 GBK shield.0004_1.ipt, 07.1 GBK shield.0005_1.ipt, 07.1 GBK shield.ipt]
2026-05-26 война со стенками продолжается
    [000 ASY GBK Gubkinskiy.0066.iam, 000 ASY GBK Gubkinskiy.0067.iam, 000 ASY GBK Gubkinskiy.iam, ASY GBK 2110 short wall shield 1.0003.iam, ASY GBK 2110 short wall shield 1.0005.iam, ASY GBK 2110 short wall shield 1.iam, ASY GBK 2120 short wall shield 2.0006.iam, ASY GBK 2120 short wall shield 2.0007.iam]
2026-05-26 маркировка+пробник
    [000 ASY GBK Gubkinskiy.0067.iam, 000 ASY GBK Gubkinskiy.0068.iam, 000 ASY GBK Gubkinskiy.iam, ASY GBK 1110 long wall shield 1_Dummy.0002.iam, ASY GBK 1110 long wall shield 1_Dummy.iam, ASY GBK 1120 long wall shield 2.0025.iam, ASY GBK 1120 long wall shield 2.0027.iam, ASY GBK 1120 long wall shield 2.iam]
2026-05-26 Маркировка дальше
    [ASY GBK 1210 long wall shield 3.0020.iam, ASY GBK 1210 long wall shield 3.0021.iam, ASY GBK 1210 long wall shield 3.iam, ASY GBK 2110 short wall shield 1.0005.iam, ASY GBK 2110 short wall shield 1.0007.iam, ASY GBK 2110 short wall shield 1.iam, ASY GBK 2120 short wall shield 2.0007.iam, ASY GBK 2120 short wall shield 2.0008.iam]
2026-05-26 докоммит
    [000 ASY GBK Gubkinskiy.0068.iam, 000 ASY GBK Gubkinskiy.0069.iam, 000 ASY GBK Gubkinskiy.iam, ASY GBK 1110 long wall shield 1.0034.iam, ASY GBK 1110 long wall shield 1.0035.iam, ASY GBK 1110 long wall shield 1.iam, ASY GBK длинная стенка.0017.iam, ASY GBK длинная стенка.0018.iam]
2026-05-26 Глеб
    Перебил названия некоторых листов. Сделал все опорные линии для стрингеров и шпангоутов. Подобрал углы для короткой стенки
    [000 ASY GBK Gubkinskiy.0069.iam, 000 ASY GBK Gubkinskiy.0071.iam, 000 ASY GBK Gubkinskiy.iam, 07.1 GBK shield.0005.ipt, 07.1 GBK shield.0005_1.ipt, 07.1 GBK shield.0006.ipt, 07.1 GBK shield.ipt, ASY GBK 1110 long wall shield 1.0035.iam]
2026-05-27 Глеб
    Все подрезал. Доп. линии нанес. Размеры проверил
    [000 ASY GBK Gubkinskiy.0071.iam, 000 ASY GBK Gubkinskiy.0075.iam, 000 ASY GBK Gubkinskiy.iam, 07.1 GBK shield.0006.ipt, 07.1 GBK shield.0007.ipt, 07.1 GBK shield.ipt, ASY GBK длинная стенка.0019.iam, ASY GBK длинная стенка.0020.iam]
2026-05-28 Новые шпангоуты
    [000 ASY GBK Gubkinskiy.0075.iam, 000 ASY GBK Gubkinskiy.0076.iam, 000 ASY GBK Gubkinskiy.iam, 07.1 GBK shield.0007.ipt, 07.1 GBK shield.0008.ipt, 07.1 GBK shield.ipt, ASY GBK 1120 long wall shield 2.0028.iam, ASY GBK 1120 long wall shield 2.0029.iam]
2026-05-28 Глеб
    Поправил черточки. Собираю среднюю стенку
    [000 ASY GBK Gubkinskiy.0077.iam, 000 ASY GBK Gubkinskiy.0078.iam, 000 ASY GBK Gubkinskiy.iam, ASY GBK 1110 long wall shield 1.0038.iam, ASY GBK 1110 long wall shield 1.0039.iam, ASY GBK 1110 long wall shield 1.iam, ASY GBK 1120 long wall shield 2.0031.iam, ASY GBK 1120 long wall shield 2.0032.iam]
2026-05-29 мелочи по шпангоутам
    [ASY GBK 1110 long wall shield 1.0038.iam, ASY GBK 1110 long wall shield 1.0040.iam, ASY GBK 1110 long wall shield 1.iam, ASY GBK 1110 long wall shield 1_Dummy.0002.iam, ASY GBK 1110 long wall shield 1_Dummy.0003.iam, ASY GBK 1110 long wall shield 1_Dummy.iam, ASY GBK 1120 long wall shield 2.0031.iam, ASY GBK 1120 long wall shield 2.0033.iam]
2026-05-31 Глеб
    Доделал центральную стенку. Все номера и доп. линии нанес. Осталось её подрезать
    [000 ASY GBK Gubkinskiy.0078.iam, 000 ASY GBK Gubkinskiy.0080.iam, 000 ASY GBK Gubkinskiy.0080_1.iam, 000 ASY GBK Gubkinskiy.iam, ASY GBK 1120 long wall shield 2.0032.iam, ASY GBK 1120 long wall shield 2.0034.iam, ASY GBK 1120 long wall shield 2.iam, ASY GBK 1210 long wall shield 3.0026.iam]
2026-06-01 Новая торцевая. подрезать
    [000 ASY GBK Gubkinskiy.0081.iam, 000 ASY GBK Gubkinskiy.0083.iam, 000 ASY GBK Gubkinskiy.iam, ASY GBK 1110 long wall shield 1.iam, ASY GBK 1120 long wall shield 2.iam, ASY GBK 1210 long wall shield 3.0027.iam, ASY GBK 1210 long wall shield 3.0028.iam, ASY GBK 1210 long wall shield 3.iam]
2026-06-01 Глеб
    Сделал новую подрезку. Проверил и поправил все опорные линии
    [000 ASY GBK Gubkinskiy.0083.iam, 000 ASY GBK Gubkinskiy.0086.iam, 000 ASY GBK Gubkinskiy.iam, ASY GBK 2110 short wall shield 1.0012.iam, ASY GBK 2110 short wall shield 1.0013.iam, ASY GBK 2110 short wall shield 1.iam, ASY GBK 2210 short wall shield 4.0015.iam, ASY GBK 2210 short wall shield 4.0017.iam]
2026-06-02 допиливаем стенки
    [000 ASY GBK Gubkinskiy.0086.iam, 000 ASY GBK Gubkinskiy.0088.iam, 000 ASY GBK Gubkinskiy.iam, ASY GBK 2230 short wall shield 6.0010.iam, ASY GBK 2230 short wall shield 6.0014.iam, ASY GBK 2230 short wall shield 6.iam, ASY GBK 2330 short wall shield 9.0009.iam, ASY GBK 2330 short wall shield 9.0011.iam]
2026-06-03 Глеб
    Отредактировал короткую стенку. Нужно смотреть
    [000 ASY GBK Gubkinskiy.0088.iam, 000 ASY GBK Gubkinskiy.0089.iam, 000 ASY GBK Gubkinskiy.iam, ASY GBK 2120 short wall shield 2.0014.iam, ASY GBK 2120 short wall shield 2.0015.iam, ASY GBK 2120 short wall shield 2.iam, ASY GBK 2210 short wall shield 4.0017.iam, ASY GBK 2210 short wall shield 4.0018.iam]
2026-06-10 Глеб
    Поправил все наружные стенки. Нужно смотреть
    [000 ASY GBK Gubkinskiy.0089.iam, 000 ASY GBK Gubkinskiy.0093.iam, 000 ASY GBK Gubkinskiy.iam, 07.1 GBK shield.0009.ipt, 07.1 GBK shield.0011.ipt, 07.1 GBK shield.ipt, ASY GBK 1110 long wall shield 1.0041.iam, ASY GBK 1110 long wall shield 1.0046.iam]
2026-06-14 Глеб
    Сделал часть чертежей
    [000 ASY GBK Gubkinskiy.0093.iam, 000 ASY GBK Gubkinskiy.0094.iam, 000 ASY GBK Gubkinskiy.iam, ASY GBK 1120 long wall shield 2.0038.iam, ASY GBK 1120 long wall shield 2.0039.iam, ASY GBK 1120 long wall shield 2.iam, ASY GBK 1320 long wall shield 5.0030.iam, ASY GBK 1320 long wall shield 5.0031.iam]
2026-06-15 отверстия в стрингерах
    [GBK 0101 main rib.ipt, GBK 0102 stringer 1.ipt, GBK 0103 stringer 2.ipt, GBK 0104 stringer 3.ipt]
2026-06-15 Глеб
    Сделал чертежи на длинную и короткую стенку
    [GBK 0000 Чертежи.idw, GBK 008 Стенка №2 Уровень №1 Щит №1.idw, GBK 009 Стенка №2 Уровень №1 Щит №2.idw, GBK 010 Стенка №2 Уровень №1 Щит №3.idw, GBK 011 Стенка №2 Уровень №2 Щит №4.idw, GBK 012 Стенка №2 Уровень №2 Щит №5.idw, GBK 013 Стенка №2 Уровень №2 Щит №6.idw, GBK 014 Стенка №2 Уровень №3 Щит №7.idw]
2026-06-16 Глеб
    Работал с третей стенкой. Перебрал все щиты, выставил нормально стрингеры и шпангоуты. Сделал все вертикальные зазоры.
    [000 ASY GBK Gubkinskiy.iam, ASY GBK 1110 long wall shield 1.iam, ASY GBK 1120 long wall shield 2.iam, ASY GBK 3110 central wall shield 1.iam, ASY GBK 3120 central wall shield 2.iam, ASY GBK 3130 central wall shield 3.iam, ASY GBK 3210 central wall shield 4.iam, ASY GBK 3220 central wall shield 5.iam]
2026-06-17 Глеб
    Выставил все щиты в средней стенке. Подрезал центральную стенку
    [000 ASY GBK Gubkinskiy.iam, ASY GBK 3110 central wall shield 1.iam, ASY GBK 3130 central wall shield 3.iam, ASY GBK 3210 central wall shield 4.iam, ASY GBK 3230 central wall shield 6.iam, ASY GBK 3310 central wall shield 7.iam, ASY GBK 3330 central wall shield 9.iam, ASY GBK центральная стенка.iam]
2026-06-18 Глеб
    Доделал все стенки. Сформировал все чертежи. Последний коммит :(
    [000 ASY GBK Gubkinskiy.iam, ASY GBK 3110 central wall shield 1.iam, ASY GBK центральная стенка.iam, GBK 0000 Чертежи.idw, GBK 008 Стенка №2 Уровень №1 Щит №1.idw, GBK 009 Стенка №2 Уровень №1 Щит №2.idw, GBK 010 Стенка №2 Уровень №1 Щит №3.idw, GBK 011 Стенка №2 Уровень №2 Щит №4.idw]
2026-06-29 Обрезка
    [000 ASY GBK Gubkinskiy CUT LASER.iam, 000 ASY GBK Gubkinskiy.iam, 07.1 GBK shield.ipt, ASY GBK 1110 long wall shield 1.iam, ASY GBK 1210 long wall shield 3.iam, ASY GBK 1310 long wall shield 4.iam, ASY GBK 3110 central wall shield 1.iam, ASY GBK 3210 central wall shield 4.iam]
2026-06-29 поправил основную сторону
    [000 ASY GBK Gubkinskiy.iam, ASY GBK 1120 long wall shield 2.iam, ASY GBK 1310 long wall shield 4.iam, ASY GBK 1320 long wall shield 5.iam, ASY GBK 2110 short wall shield 1.iam, ASY GBK 2120 short wall shield 2.iam, ASY GBK 2130 short wall shield 3.iam, ASY GBK 2210 short wall shield 4.iam]
2026-07-15 Полы
    [090 ASY bottom.iam, 0910.ipt, 0921_CPY.ipt, 0921_CPY1.ipt, 0921_CPY1_CPY.ipt, 0922_CPY1.ipt, 0923_CPY.ipt, 0923_CPY1.ipt]
2026-07-15 полы продолжение
    [090 ASY bottom.iam, 0922_CPY1.ipt, 0931_CPY.ipt, 0931_CPY1.ipt, 0932_CPY1.ipt, 0932_CPY1_CPY.ipt, ASY GBK bottom 0010.iam, ASY GBK bottom 0020.iam]
2026-07-15 схема
    [емкости в галерее.dwg]
2026-07-16 Миша
    Собрал пол
    [090 ASY bottom.iam, 0921_CPY.ipt, 0921_CPY1.ipt, 0921_CPY1_CPY.ipt, 0922_CPY1.ipt, 0923_CPY.ipt, 0923_CPY1.ipt, ASY GBK bottom 0010.iam]
2026-07-22 Dummy сепаратор
    [ASY DUMMY TANK.iam, GBK overall model.ipt, Pocket.ipt, емкости в галерее 10.07.26.dwg]
2026-08-13 Рисуем болванку емкости
    [000 ASY GBK Gubkinskiy.iam, ASY DUMMY TANK.iam, ASY GBK 2110 short wall shield 1.iam, ASY GBK 2330 short wall shield 9.iam, GBK 0000 Чертежи.idw, GBK 0101 main rib.ipt, GBK 0102 stringer 1.ipt, GBK 0103 stringer 2.ipt]
2026-08-14 Проверить спецификацию по стенам сравнить со списком изготовленных детиалей
    [000 ASY GBK Gubkinskiy.iam, ASY GBK 1120 long wall shield 2.iam, ASY GBK 1210 long wall shield 3.iam, ASY GBK длинная стенка.iam, ASY GBK короткая стенка.iam, GBK 0201 second rib.ipt, GBK 0202 stringer 4.ipt, GBK 0203 stringer 5.ipt]
2026-08-17 Поправил нумерацию
    [000 ASY GBK Gubkinskiy.iam, 07.1 GBK shield.ipt, 090 ASY bottom.iam, 092.iam, ASY DUMMY TANK.iam, ASY GBK 1110 long wall shield 1.iam, ASY GBK 1310 long wall shield 4.iam, ASY GBK 1320 long wall shield 5.iam]
2026-08-17 Обвязка профильной трубой
    [010 ASY GBK T beams 1.iam, 010 ASY GBK Tube frame 1.iam, Frame 1786954762414.iam, GBK 4001 frame 1 sketch.ipt, ISO 4019 100x100x4 1786954763984.ipt, ISO 4019 100x100x4 1786954764016.ipt, ISO 4019 100x100x4 1786954764050.ipt, ISO 4019 100x100x4 1786954764080.ipt]
2026-08-17 Вставил трубу в общую сборку
    [000 ASY GBK Gubkinskiy.iam, 010 ASY GBK T beams 1.iam, 010 ASY GBK Tube frame 1.iam, Frame 1786954762414.iam, GBK 1111 shield 1.ipt, ISO 4019 100x100x4 1786954763984.ipt, ISO 4019 100x100x4 1786954764016.ipt, ISO 4019 100x100x4 1786954764050.ipt]
2026-08-17 Рефакторинг пола
    [000 ASY GBK Gubkinskiy.iam, 010 ASY GBK Tube frame 1.iam, 090 ASY bottom.iam, ASY GBK bottom 0010.iam, ASY GBK bottom 0020.iam, ASY GBK bottom 0021.iam, ASY GBK bottom 0021_CPY.iam, ASY GBK bottom 0022.iam]
2026-08-17 Счеты железок
    [000 ASY GBK Gubkinskiy.iam, 07.1 GBK shield.ipt, GBK 0101 main rib.ipt, GBK 0102 stringer 1.ipt, GBK 0103 stringer 2.ipt, GBK 0104 stringer 3.ipt, GBK 0201 second rib.ipt, GBK 0202 stringer 4.ipt]
2026-08-17 вставить листы из GBK 0001 Чертежи гибки
    Поправил нейминг файлов сделал подсчеты по гибке и для лазера
    [000 ASY GBK Gubkinskiy.iam, 07.1 GBK shield.ipt, ASY GBK 1110 long wall shield 1.iam, ASY GBK 1120 long wall shield 2.iam, ASY GBK 1310 long wall shield 4.iam, ASY GBK 2120 short wall shield 2.iam, ASY GBK 2230 short wall shield 6.iam, ASY GBK 2330 short wall shield 9.iam]
2026-08-18 Поправил спецификацию пола
    [000 ASY GBK Gubkinskiy.iam, 090 ASY bottom.iam, ASY GBK bottom 0010.iam, ASY GBK bottom 0023.iam, GBK 0000 Чертежи.idw, GBK bottom 0113.ipt, GBK bottom 0113_CPY.ipt, GBK bottom 0124.ipt]
2026-08-18 проправил количество с учетом брка
    [000 ASY GBK Gubkinskiy.iam, GBK 0000 Чертежи.idw, GBK 0001 Чертежи гибки.idw, GBK 0101 main rib.ipt, GBK 0102 stringer 1.ipt, GBK 0103 stringer 2.ipt, GBK 0104 stringer 3.ipt, GBK 2122 shield 2.ipt]
2026-08-18 Считать верным
    [000 ASY GBK Gubkinskiy.iam, 090 ASY bottom.iam]
2026-08-19 экспорт в двг
    [000 ASY GBK Gubkinskiy.iam, 090 ASY bottom.iam, ASY GBK 1110 long wall shield 1.iam, ASY GBK 1120 long wall shield 2.iam, ASY GBK 1210 long wall shield 3.iam, ASY GBK 1310 long wall shield 4.iam, ASY GBK 1320 long wall shield 5.iam, ASY GBK 2110 short wall shield 1.iam]
2026-08-20 Поверил
    Добавил дет 3314
    [000 ASY GBK Gubkinskiy.iam, GBK 0000 Чертежи.idw, GBK 0001 Чертежи гибки.dwg, GBK 0001 Чертежи гибки.idw, GBK 0001 Чертежи лазер 20.08.26.dwg, GBK 0001 Чертежи лазер 20.08.26.dxf]
2026-08-26 распредкамера начало
    [GBK-RK-0001.iam, GBK-RK-0002 RK dummy.ipt, GBK-RK-0003 RK dummy 3.ipt]
2026-08-31 gbk 0000
    листы 003-005 переделал как образец. все стенки привести к такому же состоянию.
    если выноска не будет копироваться, то просто поставить размеры
    масштаб выносного вида 1:25 нормально помещается, можно уменьшить
    [GBK 0000 Чертежи.idw]
2026-09-14 Камера раскладка
    [Frame 1789117000139.iam, GBK ASY Gubkinskiy Distribution chamber frame dummy.iam, GBK Gubkinskiy Distribution chamber frame dummy.ipt, GBK-RK-0001.iam, GBK-RK-0004 RK dummy 4.ipt, GBK-RK-0005 RK dummy 5.ipt, GBK-RK-0011 long wall 1.ipt, GBK-RK-0013 long wall 3.ipt]
2026-09-14 Камера раскладка 0.8
    [GBK-RK-0001.iam, GBK-RK-0005 RK dummy 5.ipt, GBK-RK-0011 long wall 1.ipt, GBK-RK-0013 long wall 3.ipt, GBK-RK-0014 short wall 4.ipt, GBK-RK-0015 partition 5.ipt, GBK-RK-0016 partition 6.ipt, GBK-RK-0017 long wall 3.ipt]
2026-09-14 Сделал сборочные чертежи
    [000 ASY GBK Gubkinskiy.iam, ASY GBK центральная стенка.iam, GBK 0000 Чертежи.idw, GBK 0001 Чертежи гибки.idw, GBK 0001 Чертежи лазер 10.09.26.dwg, GBK 0001 Чертежи лазер 10.09.26.dxf, GBK 0001 на лазер 07.09.2026.dwg, GBK 0001 на лазер 07.09.2026.dxf]
2026-09-14 Поправил размеры. Добавил перегородки
    [GBK-RK-0001.iam, GBK-RK-0011 long wall 1.ipt, GBK-RK-0013 long wall 3.ipt, GBK-RK-0014 short wall 4.ipt, GBK-RK-0015 partition 5.ipt, GBK-RK-0016 partition 6.ipt, GBK-RK-0017 long wall 3.ipt, GBK-RK-0018 long wall 4.ipt]
2026-09-16 добавил ребра экспортнул в певит
    [GBK-RK-0001.iam, GBK-RK-0011 long wall 1.ipt, GBK-RK-0013 long wall 3.ipt, GBK-RK-0014 short wall 4.ipt, GBK-RK-0015 partition 5.ipt, GBK-RK-0016 partition 6.ipt, GBK-RK-0017 long wall 3.ipt, GBK-RK-0018 long wall 4.ipt]
2026-09-22 Раскрой на лазер. переименовать деталь 1 деталь 2
    [22.09.26_GBK-RK-0011 long wall 1.dxf, 22.09.26_GBK-RK-0013 long wall 3.dxf, 22.09.26_GBK-RK-0014 short wall 4.dxf, 22.09.26_GBK-RK-0015 partition 5.dxf, 22.09.26_GBK-RK-0016 partition 6.dxf, 22.09.26_GBK-RK-0017 long wall 3.dxf, 22.09.26_GBK-RK-0018 long wall 4.dxf, 22.09.26_GBK-RK-0021 bottom.dxf]
2026-09-23 новые углы
    [GBK-RK-0011 long wall 1.ipt, GBK-RK-0013 long wall 3.ipt, GBK-RK-0014 short wall 4.ipt, GBK-RK-0015 partition 5.ipt, GBK-RK-0016 partition 6.ipt, GBK-RK-0017 long wall 3.ipt, GBK-RK-0018 angle 1.ipt, GBK-RK-0018 long wall 4.ipt]
2026-09-29 Поправил имена. Подрезал перегородки. Добавил патрубок 2"
2026-10-05 Поправил ноги. Диновский отвод пока для сравнения.
2026-10-08 Поправил ноги. Отводы по din
2026-10-23 Content Center в .\cc; патрубок JIS B 2302 Close Nipple 2 пересоздан (200-Inventor)
    Claude-Session: https://claude.ai/code/session_01K2pNxa2sfrGtW8q5sziSMi
2026-10-23 Шкала расхода водослива: GBK-RK-0051/0052 weir scale R/L (2 мм, фланец 20, окна 20-50/100-150/200-250, цифры трафаретом Saira Stencil), 4 шт. на перегородке 5 в 0110, DXF развёрток (200-Inventor)
    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
2026-10-23 Шкала водослива 0051/0052: фланец убран (прямая кромка под сварку), R10 на правом верхнем углу; DXF 266x120 (200-Inventor)
    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
2026-10-23 Шкала водослива 0051/0052: R10 на обоих правых углах; DXF на лазер в Laser (mm=2_x2_23.10.26) (200-Inventor)
    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
2026-10-23 Шкалы водослива переименованы: GBK-RK-0051 Cipolletti R / 0052 Cipolletti L (ссылки в 0110 заменены), DXF на лазер в Laser; старые weir scale убраны (200-Inventor)
    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
2026-10-24 Снимок перед чертежами дренажа NDV (Дима: «закоммить всё») 24.10.26
